Harshul1484/full_panel_cleaner_Robot/gholab4.JPG

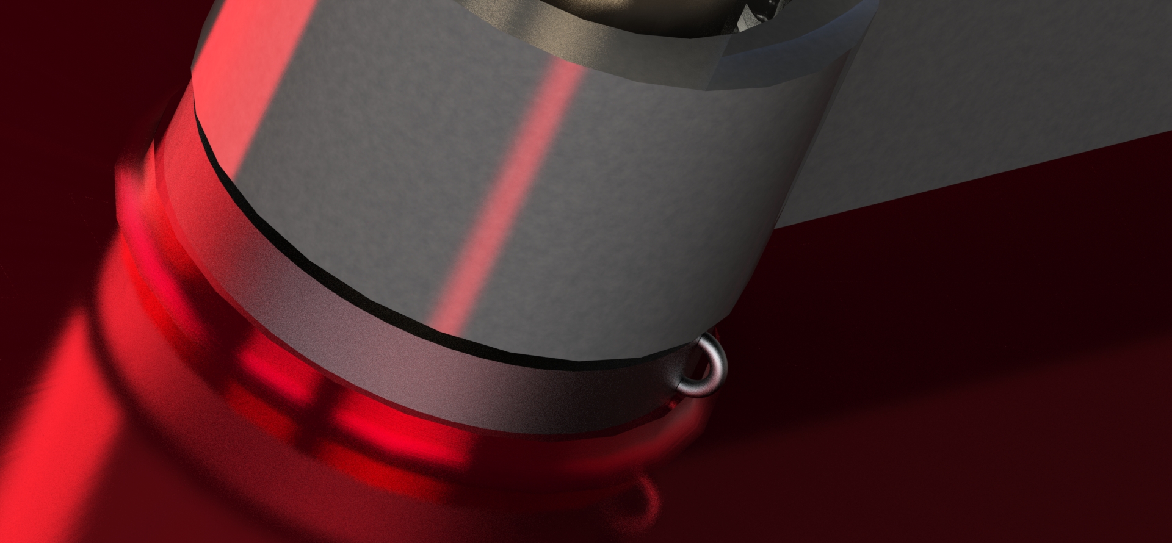
gholab4.JPG
