Harshul1484/full_panel_cleaner_Robot/render2.JPG

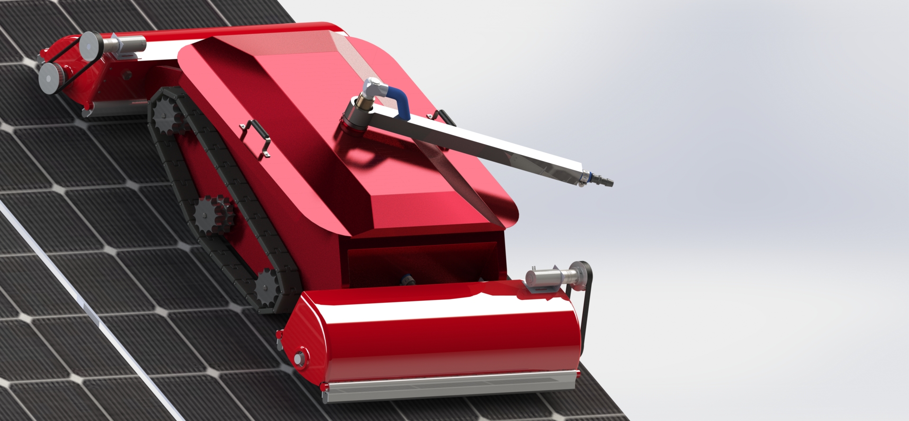
render2.JPG
