Harshul1484/full_panel_cleaner_Robot/render1.JPG

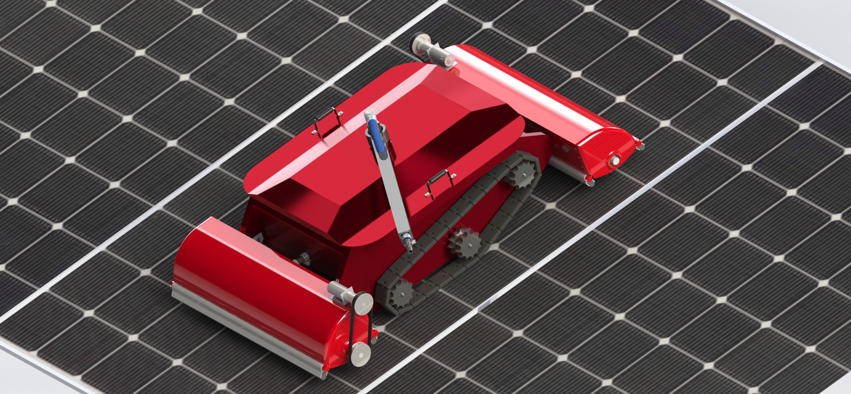
render1.JPG
