Harshul1484/full_panel_cleaner_Robot/robot1.JPG

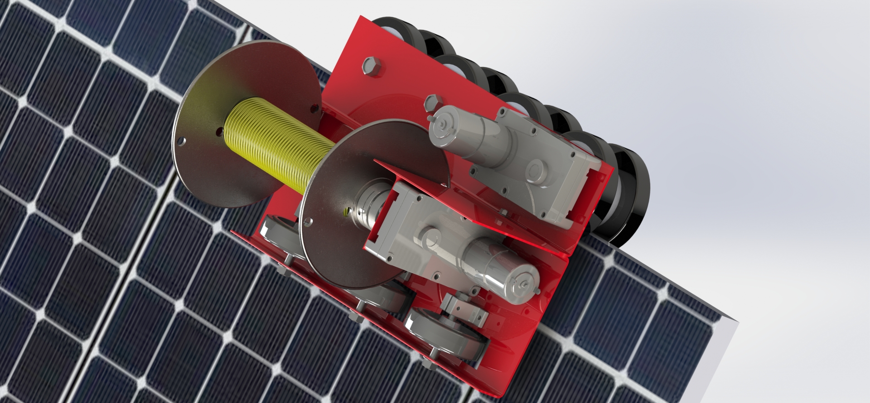
robot1.JPG
