Harshul1484/full_panel_cleaner_Robot/components/3d-print/main_body_part2.stl

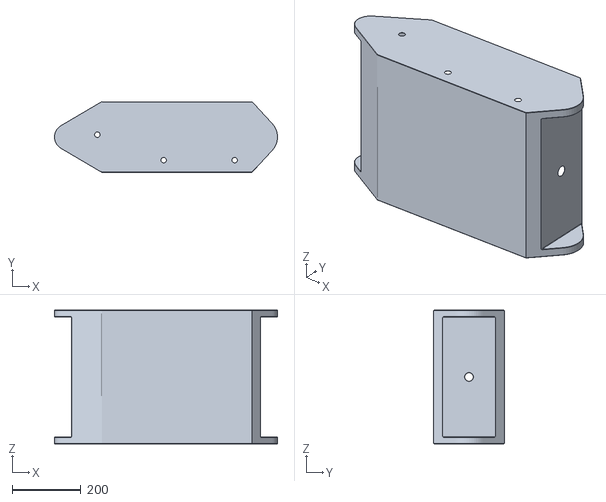
[picture p5: CAD file, 2026-05-20]
components/3d-print/main_body_part2.stl
650.0 x 205.9 x 390.0
