Harshul1484/full_panel_cleaner_Robot/components/assemblies/T-part-assemble.step

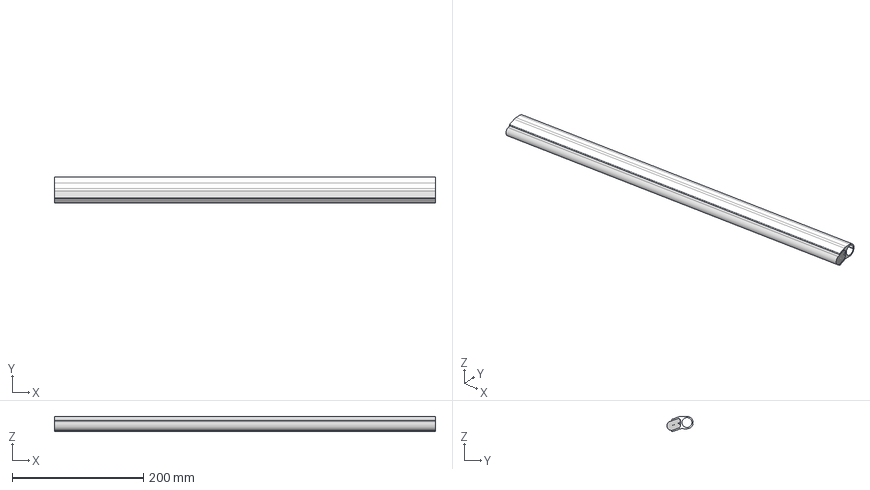
[picture p6: CAD file, 2026-05-20]
components/assemblies/T-part-assemble.step
580.0 x 40.1 x 23.4 mm
