Harshul1484/full_panel_cleaner_Robot/components/3d-print/main_body_part1.stl

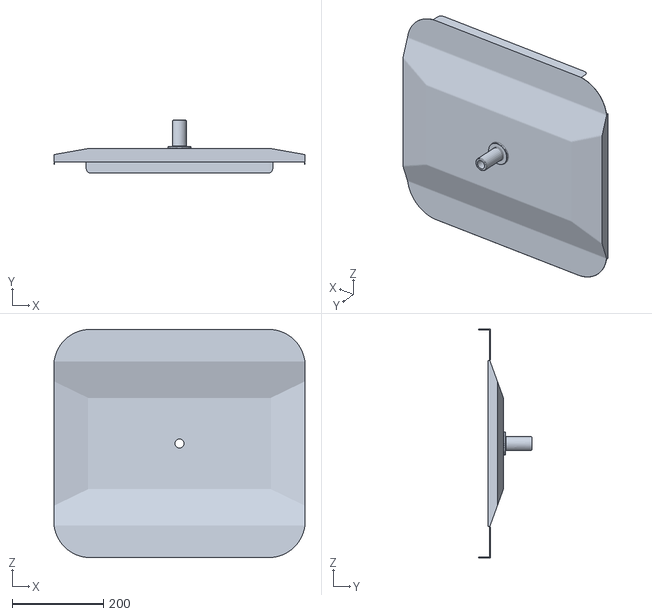
[picture p7: CAD file, 2026-05-20]
components/3d-print/main_body_part1.stl
550.0 x 117.1 x 500.0
