Harshul1484/full_panel_cleaner_Robot/main_body.SLDPRT

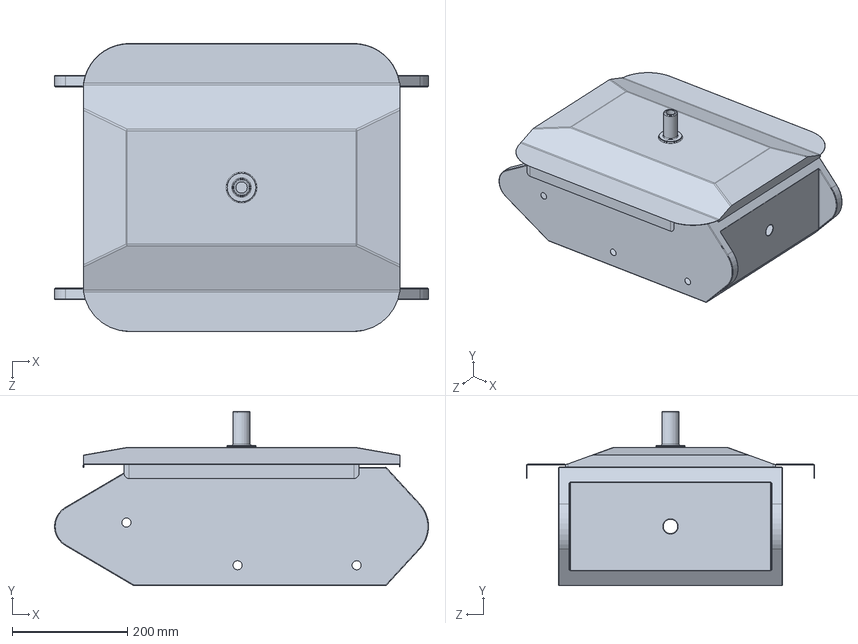
[picture p8: CAD file, 2026-05-20]
main_body.SLDPRT
649.8 x 303.0 x 500.0 mm
