Harshul1484/full_panel_cleaner_Robot/1ofsheni.SLDASM

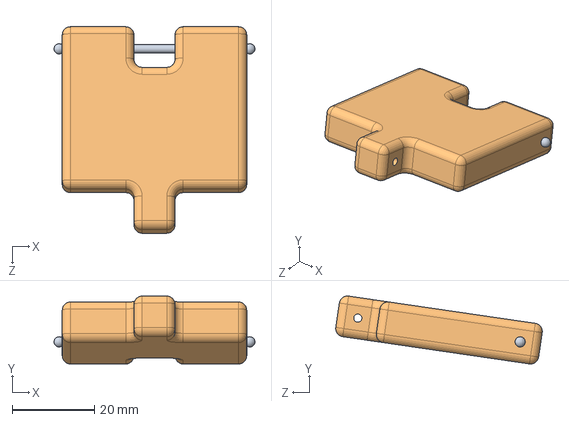
[picture p9: CAD file, 2026-05-20]
1ofsheni.SLDASM
49.0 x 16.6 x 50.4 mm
shaft_sheni
sheni
