Harshul1484/full_panel_cleaner_Robot/components/assemblies/ST-320.step

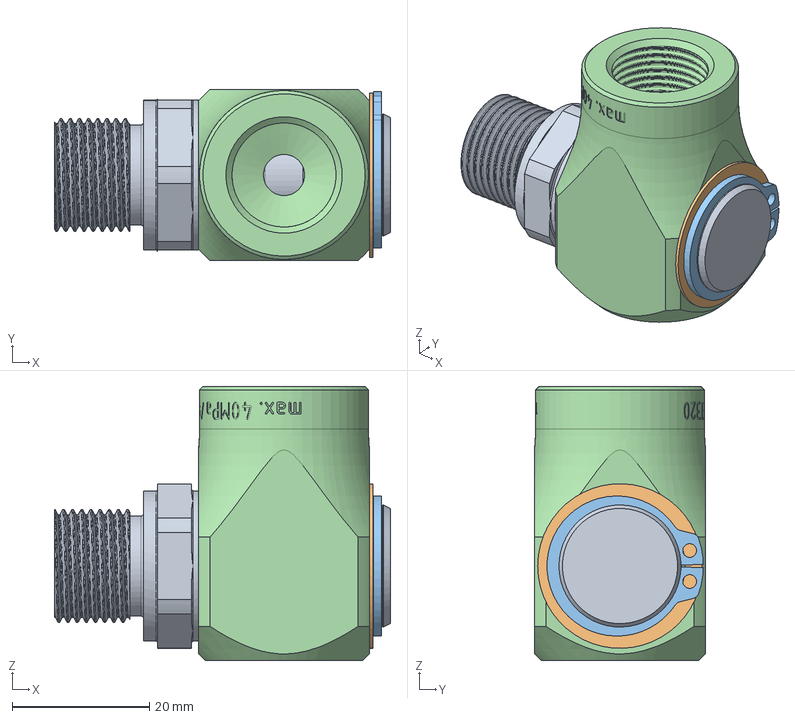
[picture p10: CAD file, 2026-05-20]
components/assemblies/ST-320.step
49.0 x 25.0 x 40.0 mm
