Harshul1484/full_panel_cleaner_Robot/components/cut-mild-steel/structure_body2_40x1000x20mm.stl

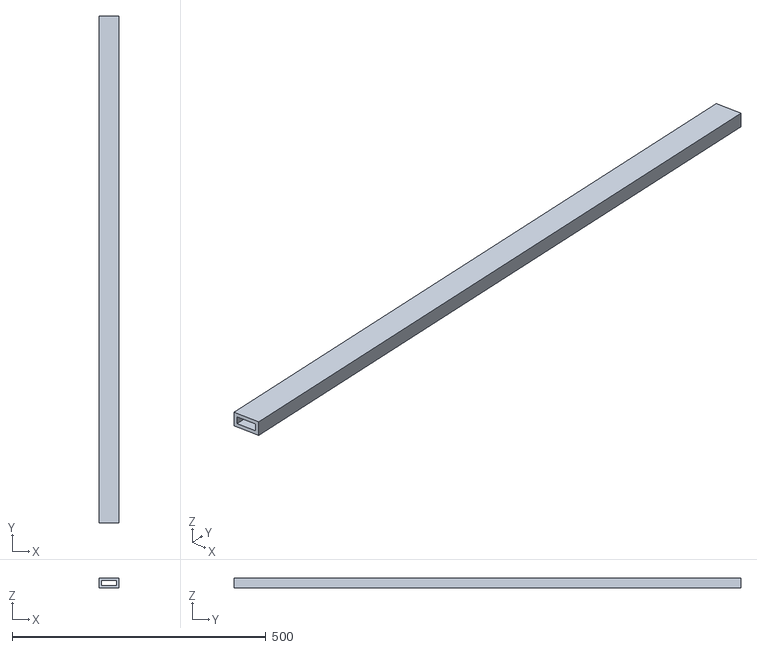
[picture p12: CAD file, 2026-05-20]
components/cut-mild-steel/structure_body2_40x1000x20mm.stl
40.0 x 1000.0 x 20.0
