Harshul1484/full_panel_cleaner_Robot/components/3d-print/T-cleaner-body.step

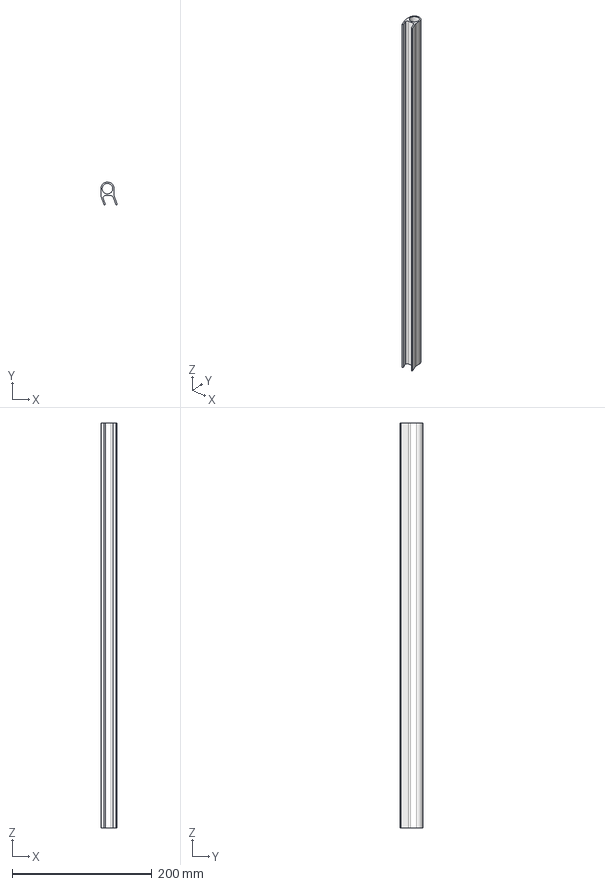
[picture p13: CAD file, 2026-05-20]
components/3d-print/T-cleaner-body.step
23.4 x 32.8 x 580.0 mm
