Harshul1484/full_panel_cleaner_Robot/shaft_sheni.SLDPRT

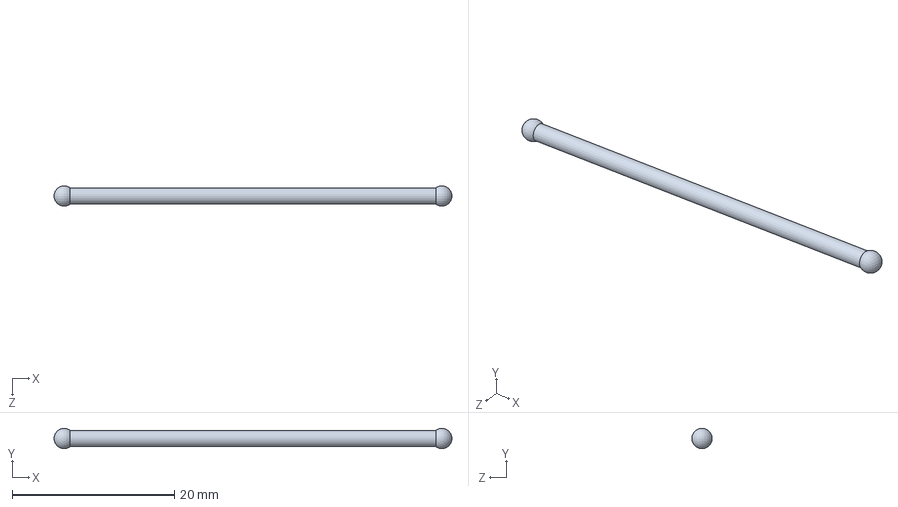
[picture p14: CAD file, 2026-05-20]
shaft_sheni.SLDPRT
49.0 x 2.50 x 2.50 mm
