Harshul1484/full_panel_cleaner_Robot/components/3d-print/motor-DC-shaft.step

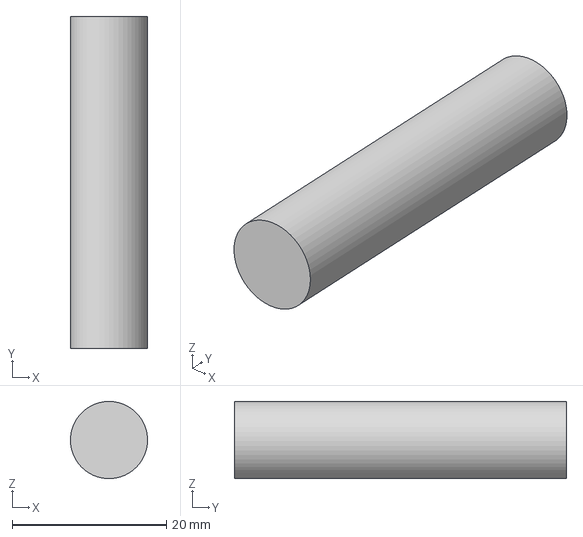
[picture p15: CAD file, 2026-05-20]
components/3d-print/motor-DC-shaft.step
10.00 x 43.0 x 9.99 mm
