Harshul1484/full_panel_cleaner_Robot/components/bought-parts/Composant2.step.step

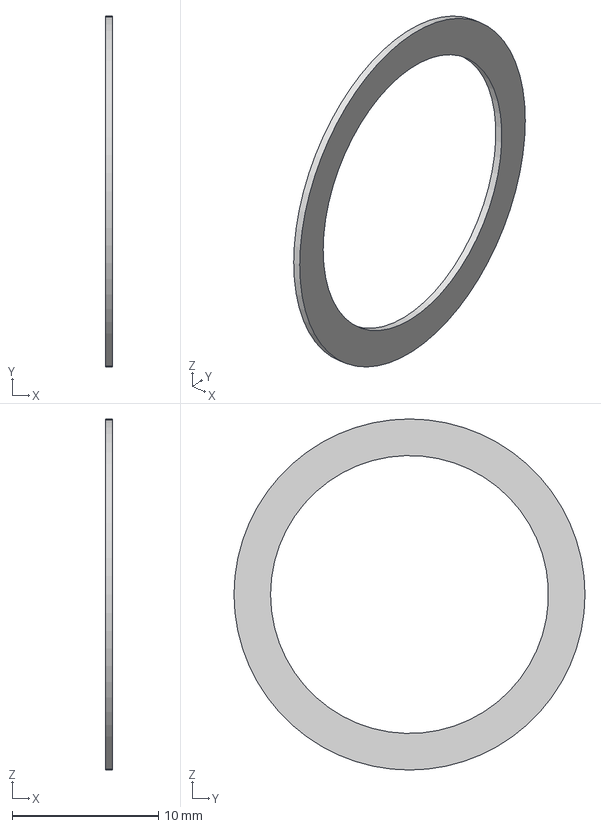
[picture p16: CAD file, 2026-05-20]
components/bought-parts/Composant2.step.step
0.5 x 24.0 x 24.0 mm
