Harshul1484/full_panel_cleaner_Robot/components/cut-mild-steel/structure_body8_40x1866x20mm.stl

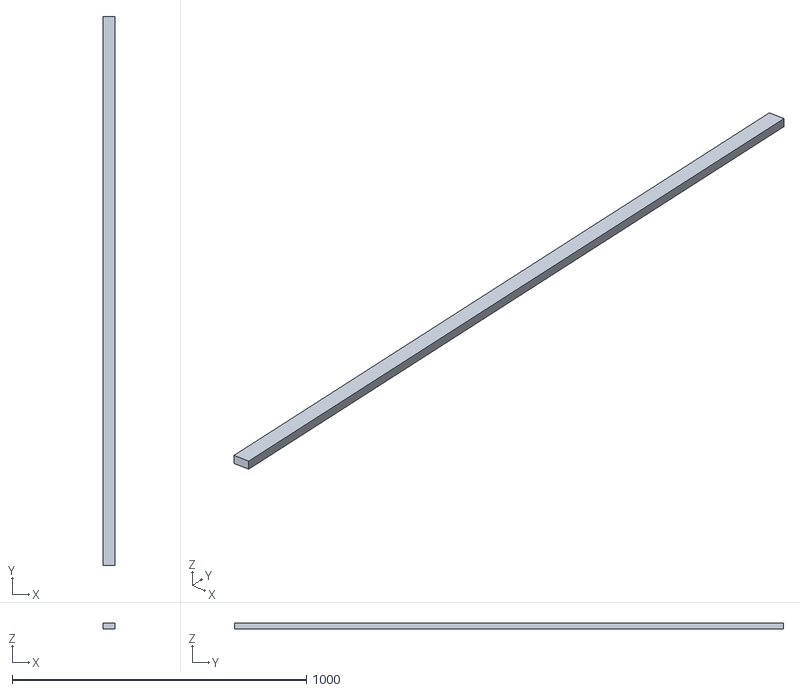
[picture p17: CAD file, 2026-05-20]
components/cut-mild-steel/structure_body8_40x1866x20mm.stl
40.0 x 1866.0 x 20.0
