Harshul1484/full_panel_cleaner_Robot/connector.SLDPRT

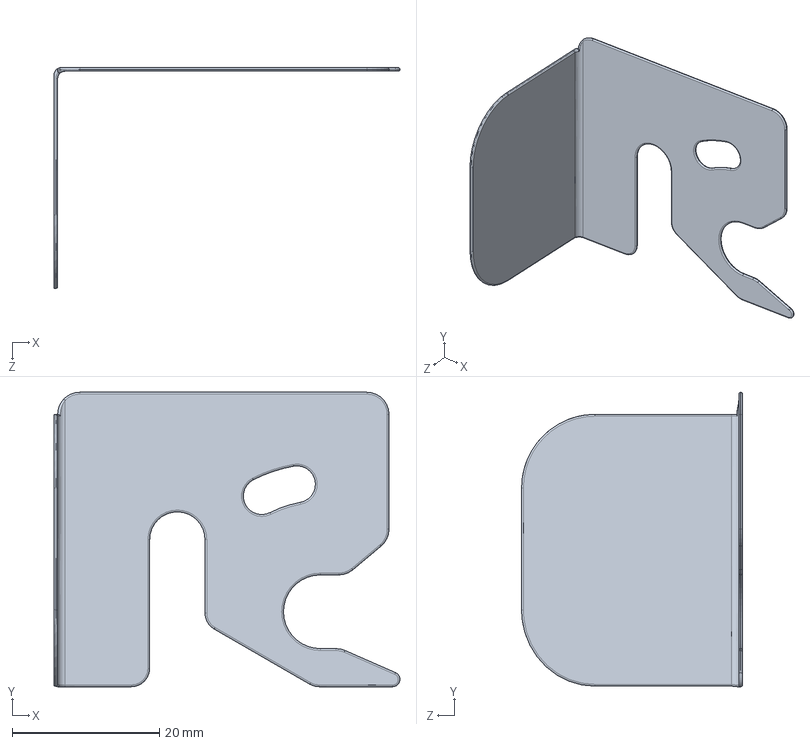
[picture p18: CAD file, 2026-05-20]
connector.SLDPRT
47.0 x 40.0 x 30.0 mm
