Harshul1484/full_panel_cleaner_Robot/components/bought-parts/ST-320.step.step

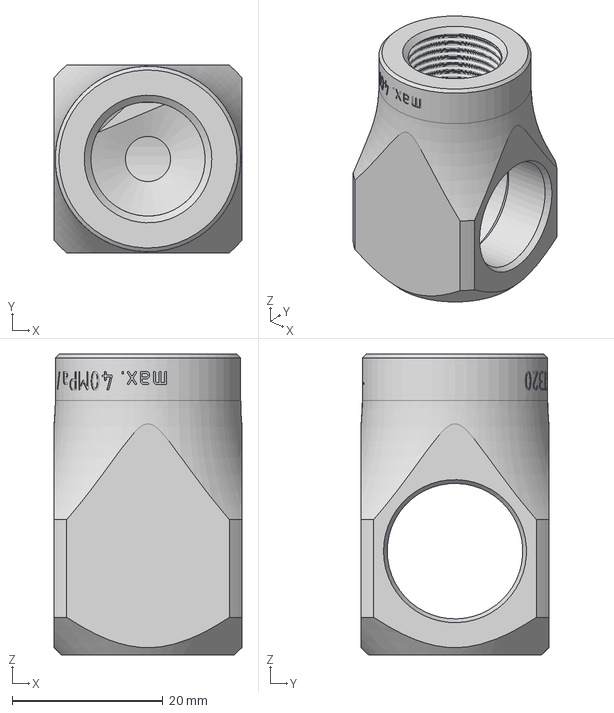
[picture p19: CAD file, 2026-05-20]
components/bought-parts/ST-320.step.step
25.0 x 25.0 x 40.0 mm
