Harshul1484/full_panel_cleaner_Robot/motor-DC-shaft.SLDPRT

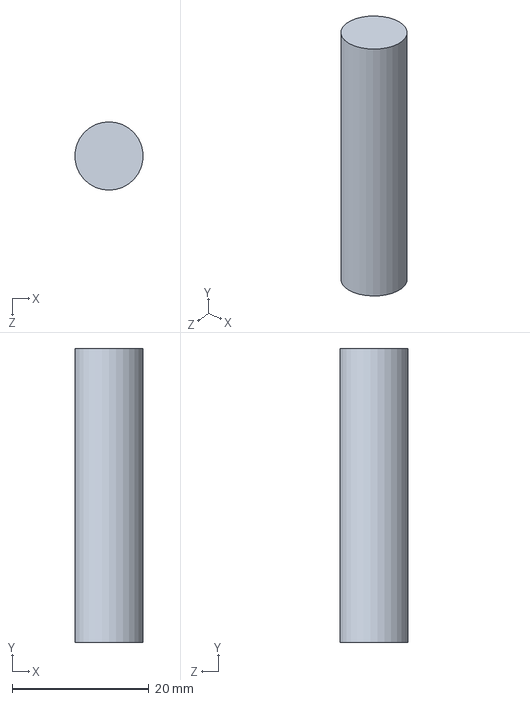
[picture p20: CAD file, 2026-05-20]
motor-DC-shaft.SLDPRT
9.95 x 43.0 x 10.0 mm
