Harshul1484/full_panel_cleaner_Robot/components/3d-print/pin.step

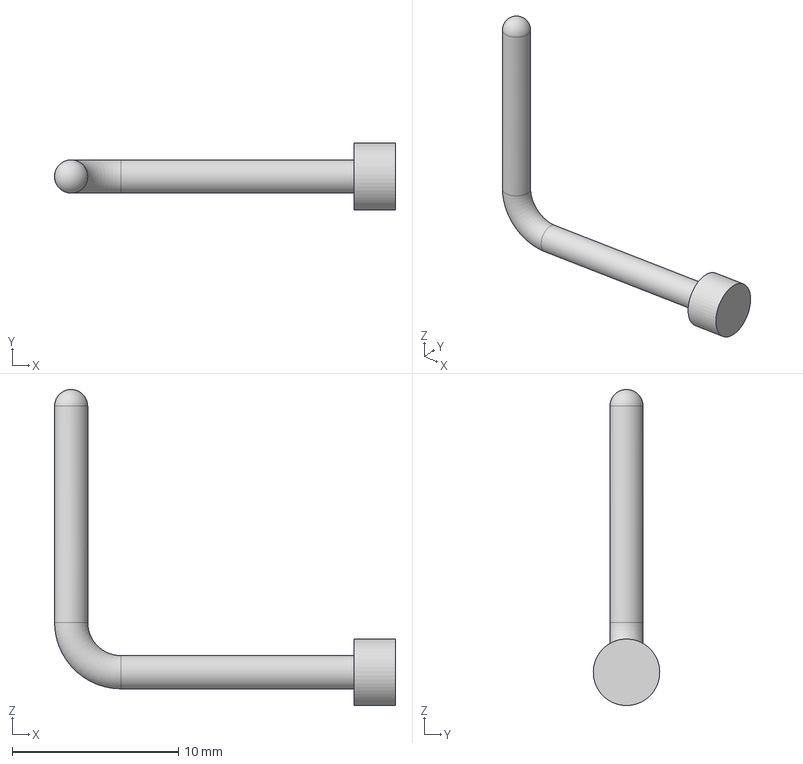
[picture p21: CAD file, 2026-05-20]
components/3d-print/pin.step
20.5 x 4.00 x 19.0 mm
