Harshul1484/full_panel_cleaner_Robot/components/3d-print/dasteh.step

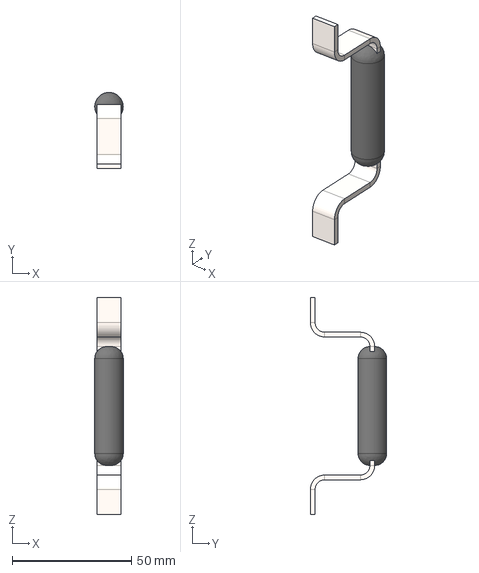
[picture p22: CAD file, 2026-05-20]
components/3d-print/dasteh.step
12.0 x 32.0 x 91.2 mm
