Harshul1484/full_panel_cleaner_Robot/radial ball bearing_68_am.sldprt

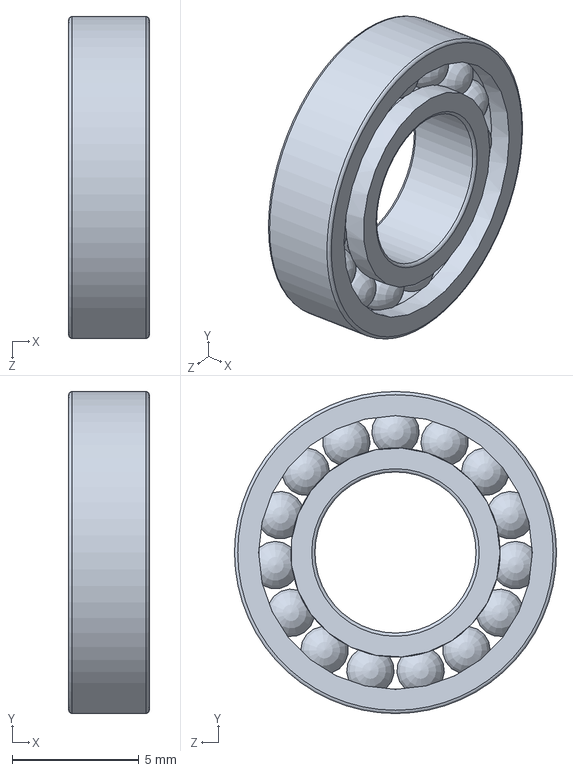
[picture p23: CAD file, 2026-05-20]
radial ball bearing_68_am.sldprt
3.17 x 12.7 x 12.7 mm
