Harshul1484/full_panel_cleaner_Robot/components/3d-print/DC-motor-bracket.step

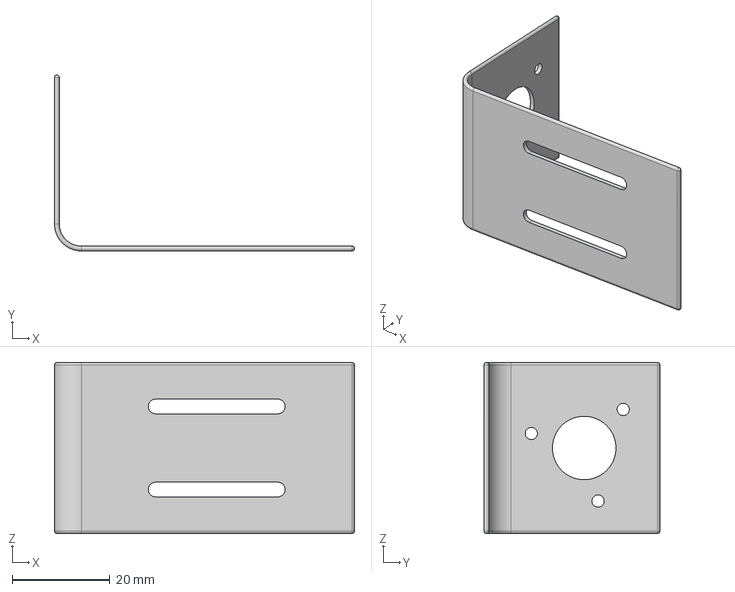
[picture p24: CAD file, 2026-05-20]
components/3d-print/DC-motor-bracket.step
61.4 x 36.0 x 35.0 mm
