Harshul1484/full_panel_cleaner_Robot/components/bought-parts/Axe.step.step

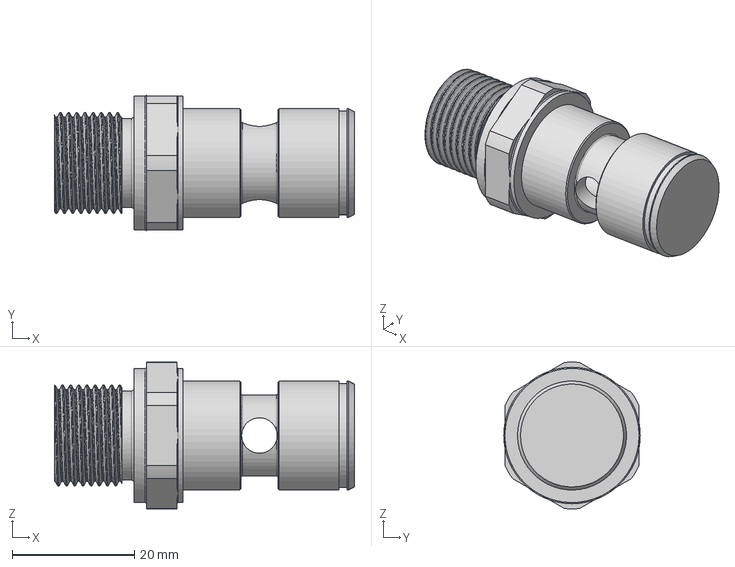
[picture p25: CAD file, 2026-05-20]
components/bought-parts/Axe.step.step
49.0 x 22.3 x 24.0 mm
