Harshul1484/full_panel_cleaner_Robot/components/3d-print/shaft_harzgard.step

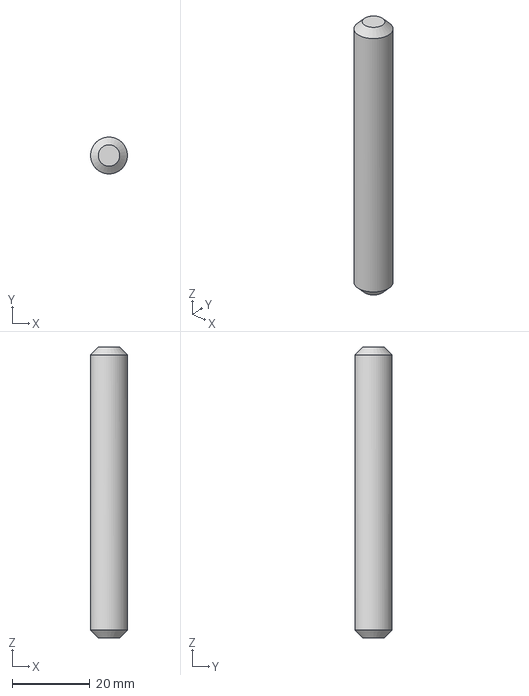
[picture p26: CAD file, 2026-05-20]
components/3d-print/shaft_harzgard.step
9.50 x 9.50 x 75.0 mm
