Harshul1484/full_panel_cleaner_Robot/components/bought-parts/instrument_ball_bearing_ai.step

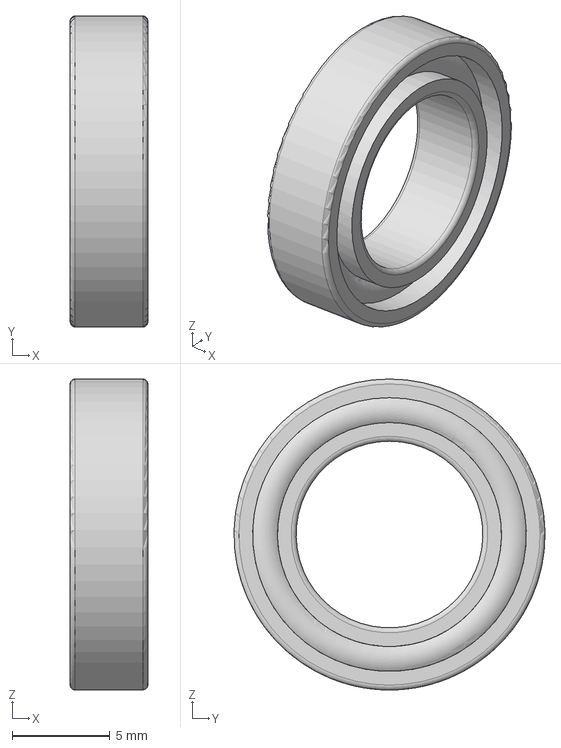
[picture p27: CAD file, 2026-05-20]
components/bought-parts/instrument_ball_bearing_ai.step
3.97 x 15.9 x 15.9 mm
