Harshul1484/full_panel_cleaner_Robot/structure.SLDPRT

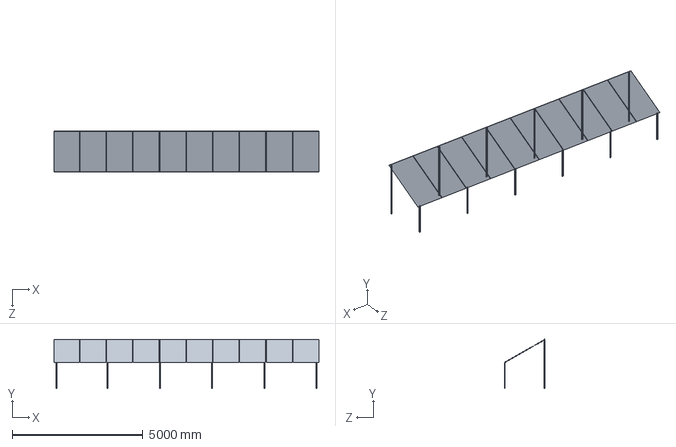
[picture p28: CAD file, 2026-05-20]
structure.SLDPRT
10151.0 x 1892.6 x 1559.9 mm
