Harshul1484/full_panel_cleaner_Robot/instrument ball bearing_ai.sldprt

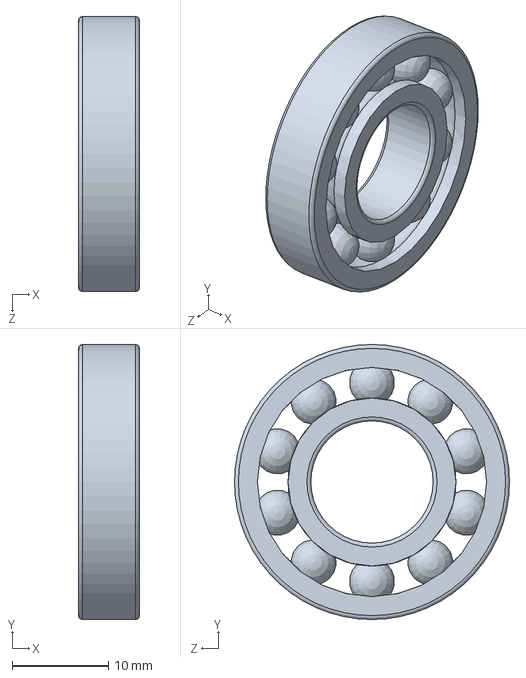
[picture p29: CAD file, 2026-05-20]
instrument ball bearing_ai.sldprt
6.35 x 28.6 x 28.6 mm
