Harshul1484/full_panel_cleaner_Robot/components/3d-print/head-of-T-cleaner.step

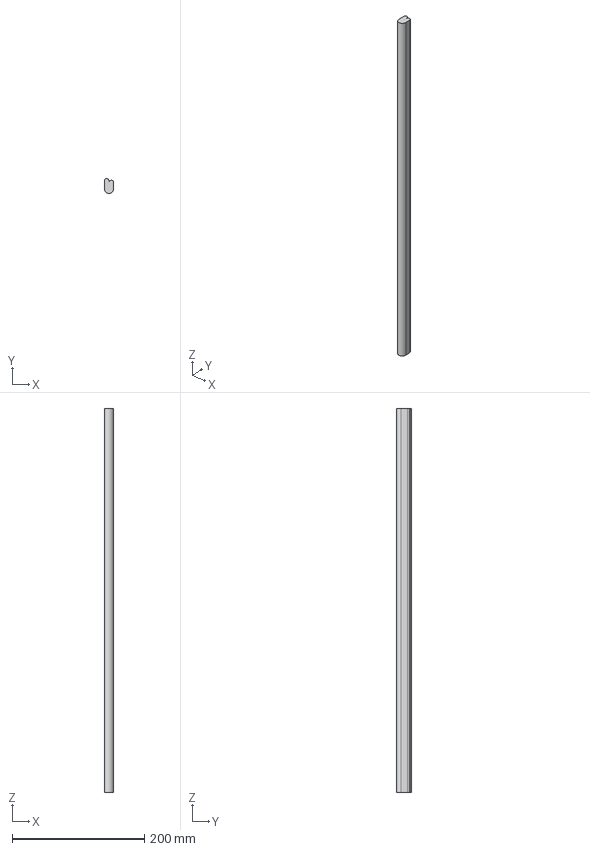
[picture p30: CAD file, 2026-05-20]
components/3d-print/head-of-T-cleaner.step
14.0 x 22.5 x 580.0 mm
