Harshul1484/full_panel_cleaner_Robot/components/3d-print/copling.step

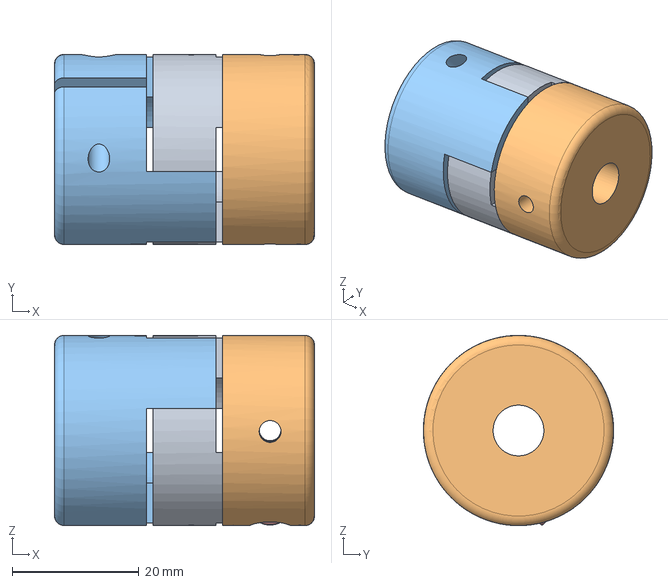
[picture p31: CAD file, 2026-05-20]
components/3d-print/copling.step
41.0 x 30.0 x 30.0 mm
