Harshul1484/full_panel_cleaner_Robot/components/bought-parts/GF555.STEP.step

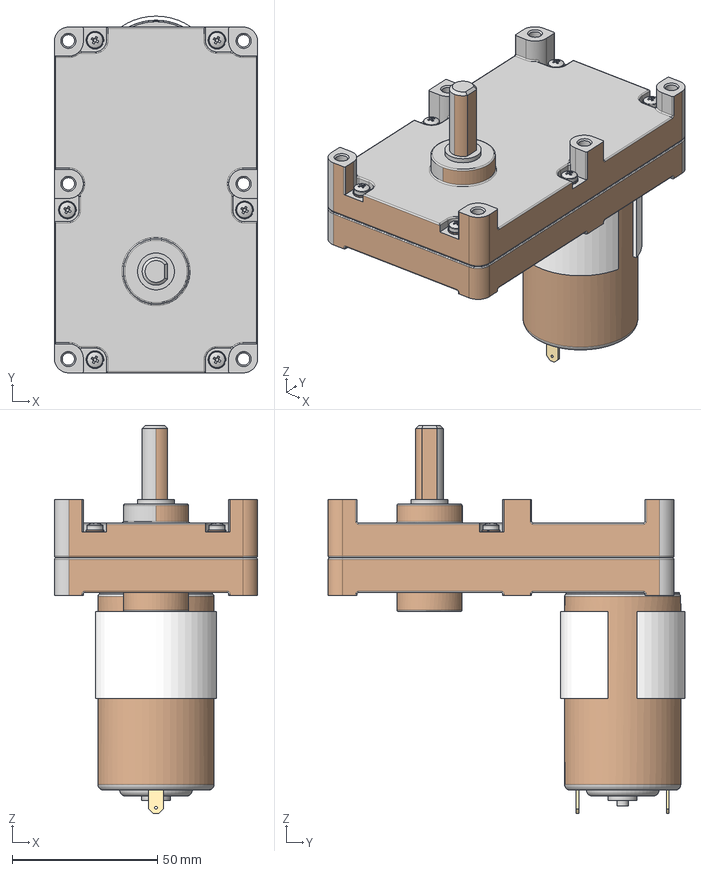
[picture p32: CAD file, 2026-05-20]
components/bought-parts/GF555.STEP.step
70.0 x 122.8 x 133.5 mm
