Harshul1484/full_panel_cleaner_Robot/components/3d-print/loleh_dakheli.step

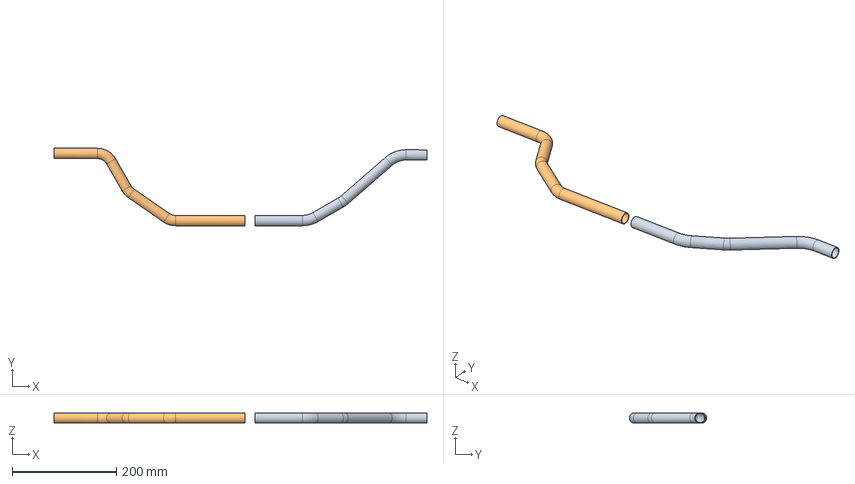
[picture p33: CAD file, 2026-05-20]
components/3d-print/loleh_dakheli.step
715.2 x 148.6 x 20.0 mm
