Harshul1484/full_panel_cleaner_Robot/components/3d-print/3rahi.step

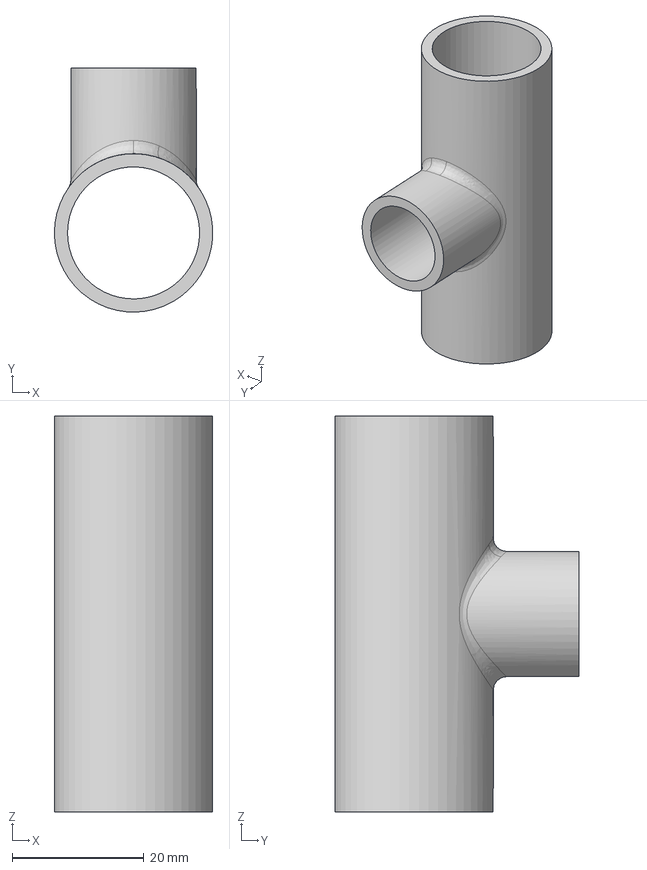
[picture p34: CAD file, 2026-05-20]
components/3d-print/3rahi.step
24.0 x 37.0 x 60.0 mm
