Harshul1484/full_panel_cleaner_Robot/components/bought-parts/6260K9_Double-Strand_Roller_Chain_Idler_Sprocket.step

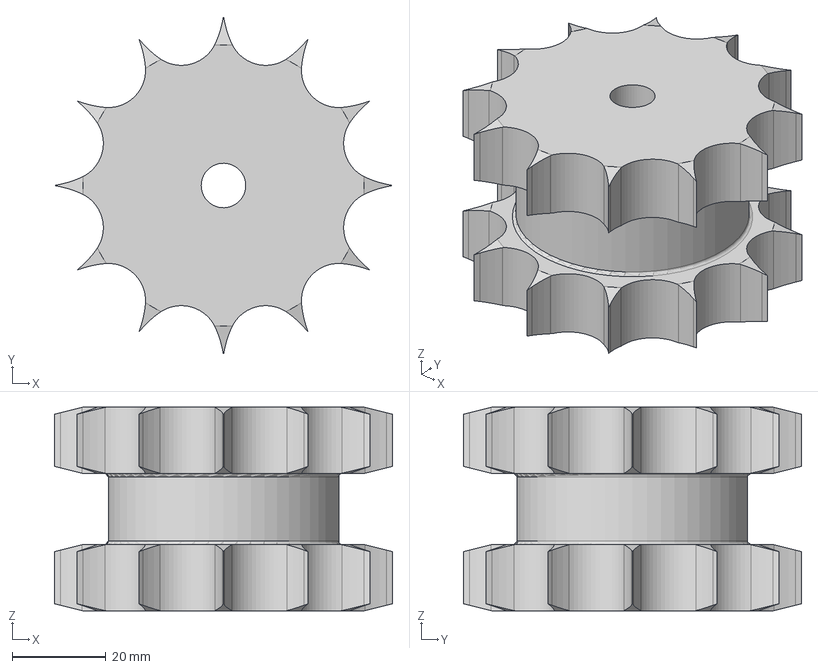
[picture p35: CAD file, 2026-05-20]
components/bought-parts/6260K9_Double-Strand_Roller_Chain_Idler_Sprocket.step
72.1 x 72.1 x 43.4 mm
