Harshul1484/full_panel_cleaner_Robot/components/3d-print/water-jet.step

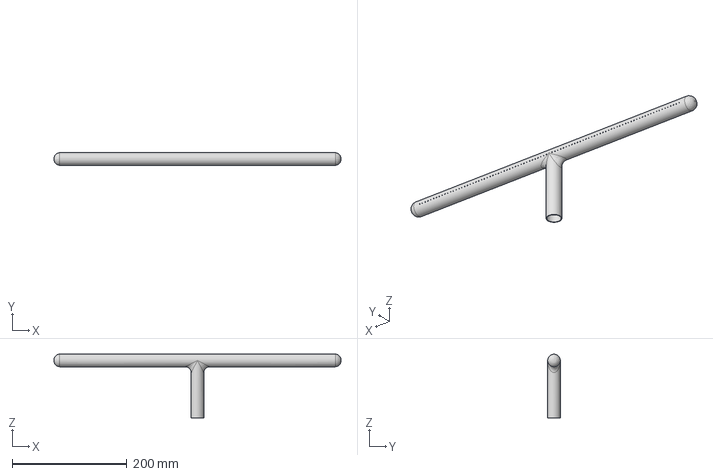
[picture p36: CAD file, 2026-05-20]
components/3d-print/water-jet.step
500.0 x 22.0 x 111.0 mm
