Harshul1484/full_panel_cleaner_Robot/gard.SLDPRT

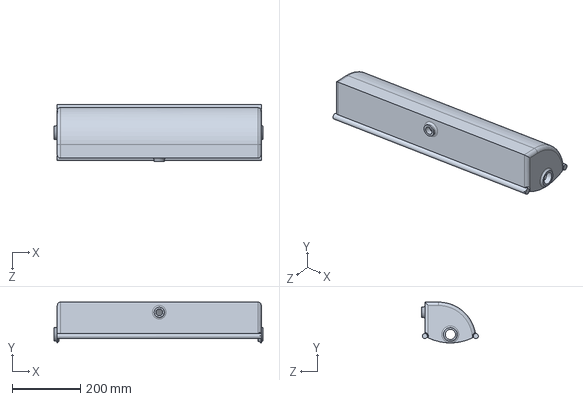
[picture p37: CAD file, 2026-05-20]
gard.SLDPRT
614.5 x 120.1 x 167.0 mm
