Harshul1484/full_panel_cleaner_Robot/3rahi.SLDPRT

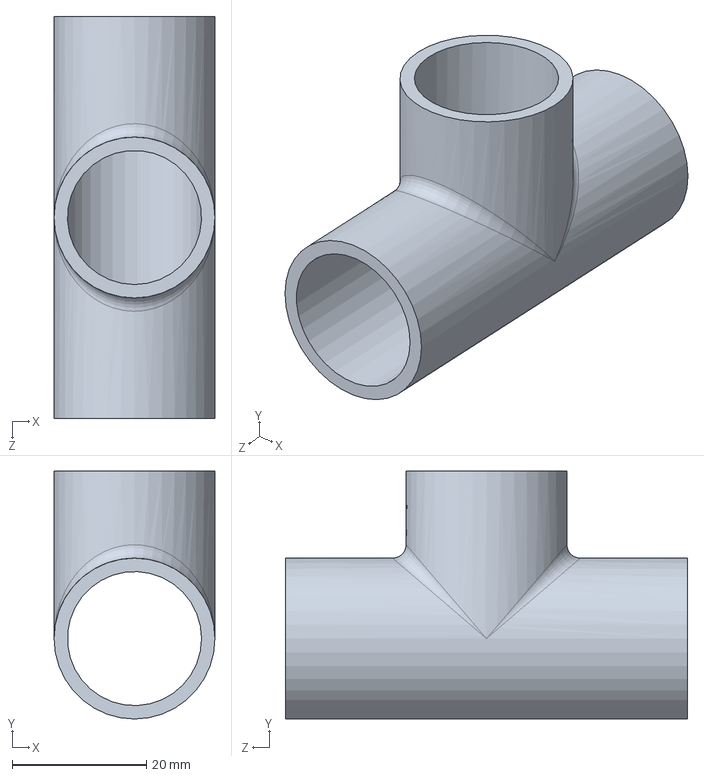
[picture p38: CAD file, 2026-05-20]
3rahi.SLDPRT
24.0 x 37.0 x 60.0 mm
