Harshul1484/full_panel_cleaner_Robot/components/3d-print/sheni.step

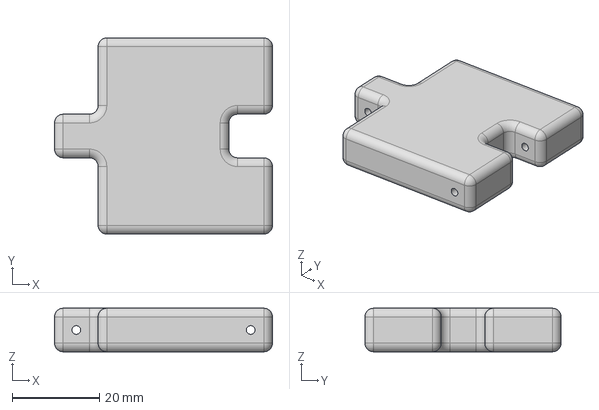
[picture p39: CAD file, 2026-05-20]
components/3d-print/sheni.step
50.0 x 45.0 x 10.0 mm
