Harshul1484/full_panel_cleaner_Robot/components/bought-parts/Variklio_korpusas.STEP.step

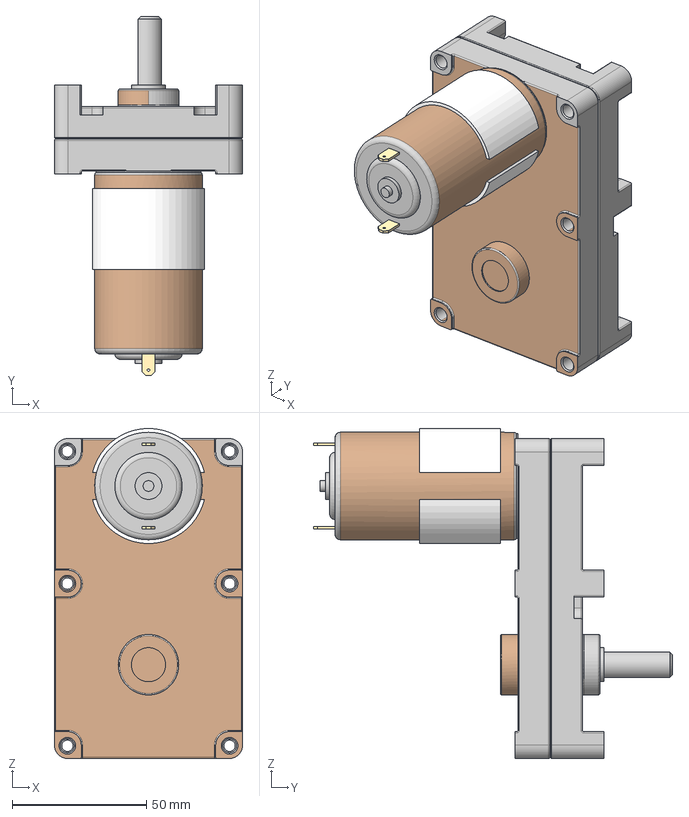
[picture p40: CAD file, 2026-05-20]
components/bought-parts/Variklio_korpusas.STEP.step
70.0 x 133.5 x 122.8 mm
