Harshul1484/full_panel_cleaner_Robot/loleh_dakheli.SLDPRT

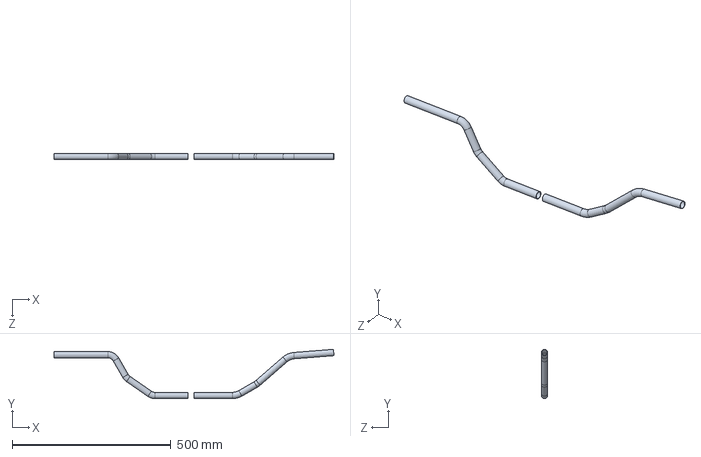
[picture p41: CAD file, 2026-05-20]
loleh_dakheli.SLDPRT
882.8 x 155.5 x 20.0 mm
