Harshul1484/full_panel_cleaner_Robot/(list of files, cad)

Other CAD files:
components/3d-print/main_body.step
T-part-assemble.SLDASM
components/assemblies/1ofsheni.step
components/cut-mild-steel/structure_body6_40x1866x20mm.stl
components/cut-mild-steel/structure_body3_40x1000x20mm.stl
components/3d-print/shaft_sheni.step
components/cut-mild-steel/structure_body9_40x1000x20mm.stl
components/cut-mild-steel/structure_body10_40x1000x20mm.stl
components/cut-mild-steel/structure_body5_40x1866x20mm.stl
components/cut-mild-steel/structure_body4_40x1000x20mm.stl
components/cut-mild-steel/structure_body1_40x1000x20mm.stl
components/cut-mild-steel/structure_body12_40x1866x20mm.stl
dasteh.SLDPRT
components/cut-mild-steel/structure_body7_40x1866x20mm.stl
connector2.SLDPRT
components/3d-print/connector2.step
components/3d-print/connector.step
components/3d-print/gard.step
pin.SLDPRT
T-cleaner-body.SLDPRT
head-of-T-cleaner.SLDPRT
shaft_harzgard.SLDPRT
DC-motor-bracket.SLDPRT
GF555.STEP
sheni.SLDPRT
ST-320.step
6260K9_Double-Strand Roller Chain Idler Sprocket.SLDPRT
water-jet.SLDPRT
copling.SLDPRT
1277N723_Corrosion-Resistant Timing Belt Pulley.SLDPRT
1277N725_Corrosion-Resistant Timing Belt Pulley.SLDPRT
3273T51_304 Stainless Steel Threaded-Rod-Mount Loop Hanger.SLDPRT
4147N173_Set Screw Precision Flexible Shaft Couplings.SLDPRT
5011T11_Worm-Drive Clamp for Firm Hose and Tube.SLDPRT
5972K244_Ball Bearing-brash-gard.SLDPRT
6331K61_Compact Round-Face DC Motor.SLDPRT
9675T18_Odor-Resistant Plastic Barbed Tube Fitting.SLDPRT
ST-320.SLDASM
components/3d-print/3rahi.stl
components/3d-print/Belt1-3.stl
components/3d-print/DC-motor-bracket.stl
components/3d-print/T-cleaner-body.stl
components/3d-print/connector.stl
components/3d-print/connector2.stl
components/3d-print/copling.stl
components/3d-print/dasteh.stl
components/3d-print/gard.stl
components/3d-print/gholab.stl
components/3d-print/head-of-T-cleaner.stl
components/3d-print/loleh.stl
components/3d-print/loleh_dakheli.stl
components/3d-print/motor-DC-shaft.stl
components/3d-print/pin.stl
components/3d-print/rabet.stl
components/3d-print/shaft_harzgard.stl
components/3d-print/shaft_sheni.stl
components/3d-print/sheni.stl
components/3d-print/water-jet.stl
components/bought-parts/1277N723_Corrosion-Resistant_Timing_Belt_Pulley.step
components/bought-parts/1277N725_Corrosion-Resistant_Timing_Belt_Pulley.step
components/bought-parts/3273T51_304_Stainless_Steel_Threaded-Rod-Mount_Loop_Hanger.step
components/bought-parts/4147N173_Set_Screw_Precision_Flexible_Shaft_Couplings.step
components/bought-parts/5011T11_Worm-Drive_Clamp_for_Firm_Hose_and_Tube.step
components/bought-parts/5972K244_Ball_Bearing-brash-gard.step
components/bought-parts/6331K61_Compact_Round-Face_DC_Motor.step
components/bought-parts/90967A220_External_Retaining_Ring.step.step
components/bought-parts/9675T18_Odor-Resistant_Plastic_Barbed_Tube_Fitting.step
components/bought-parts/hex_head_tapping_screw_am.step
components/bought-parts/pan_head_cross_recess_screw_din_ISO_7045_-_M3_x_10_-_Z_---_10N.STEP.step
components/bought-parts/prevailing_torque_hex_flange_nut_am.step
components/bought-parts/socket_countersunk_head_screw_am.step
components/bought-parts/socket_head_cap_screw_ai.step
components/bought-parts/socket_head_cap_screw_am.step
components/bought-parts/socket_set_screw_cup_point_am.step
components/bought-parts/spring_lock_washer_2_din_DIN_6905-3.2-FSt.STEP.step
hex head tapping screw_am.sldprt
prevailing torque hex flange nut_am.sldprt
socket countersunk head screw_am.sldprt
socket head cap screw_ai.sldprt
socket head cap screw_am.sldprt
socket set screw cup point_am.sldprt
