Harshul1484/full_panel_cleaner_Robot/MechanicalBuildGuide.html

# SOLARCLEANERBOT — MECHANICAL BUILD GUIDE

Panel: 2000 × 1000 mm · 2× GF555 Differential Drive · Material: Mild Steel + 3D Print (NO aluminium) · Tools: Laser/Hacksaw, 3D Printer, Drill, Grinder

LASER CUT Flat sheet parts cut by laser 3D PRINT Print on FDM printer CUT/GRIND Hacksaw or angle grinder DRILL Drill press or hand drill BUY Purchase ready-made MACHINE Lathe / milling needed

TABLE OF CONTENTS

Understanding the robot

How the robot works mechanically

Phase 1 — Materials & Shopping

Complete laser cut parts list Mild steel stock to buy and cut to size (no aluminium) 3D printed parts list Bolts, nuts, bearings — full hardware list with sizes Ready-made bought parts

Phase 2 — Chassis Frame

Building the main frame step by step

Phase 3 — Drive System

Track drive: 2× GF555 motors (differential) + sprockets + ST-320 chain

Phase 4 — Brush Wash Assembly

Brush rollers + motor + belt drive + water jet

Phase 5 — Sensor Mounting

All sensors — exact positions and how to mount them

Phase 6 — Final Assembly

Putting it all together in order

Phase 7 — Checks Before First Run

Mechanical checklist before powering on

0

HOW THE ROBOT WORKS — READ THIS FIRST

Simple explanation of every mechanical part before you build anything

🚗 How it moves

Two GF555 motors — one per side. Left motor drives the left track, right motor drives the right track independently. By running them at different speeds or opposite directions the robot steers and spins in place — called differential drive, exactly like a tank.

🧹 How it cleans

Two brush rollers (front and rear, each 650mm wide) spin and scrub the panel. A water jet pipe sprays water ahead of the front brush. Together they wet-scrub the whole panel surface.

🔄 How it knows where it is

IR sensors at each corner look down. When a sensor sees no surface (panel edge), the robot knows to turn. It sweeps in an S-pattern row by row until the full panel is clean.

1A

LASER CUT PARTS LIST LASER CUT

Send these files to a laser cutting service or cut yourself — all flat sheet parts

ℹ If you don't have a laser cutter, services like SendCutSend, Xometry, or local fab labs will cut these from a DXF file. Get the DXF from your SolidWorks model for each part below. All structural parts are mild steel — cheaper, stronger, easier to weld, widely available.

⚠ Rust protection is mandatory. Mild steel corrodes outdoors on a solar panel. After cutting and drilling ALL steel parts: sand edges smooth → apply zinc primer spray → top-coat with outdoor enamel paint. Do this before assembly. Alternatively, buy galvanised (zinc-coated) mild steel sheet — same price, pre-protected.

Side Plates, End Plates & Frame — 3mm Mild Steel Sheet

Part Name | Size (mm) | Qty | Material | Notes
Left Side Plate | 820 × 150 × 3mm | 1 | Mild steel 3mm sheet | Main left wall of chassis. Has holes for bearing mounts and motor shaft. Use galvanised sheet or paint after cutting.
Right Side Plate | 820 × 150 × 3mm | 1 | Mild steel 3mm sheet | Mirror image of left plate. Same hole pattern. Can weld cross braces directly to steel — stronger than bolted connections.
Front End Plate | 650 × 150 × 3mm | 1 | Mild steel 3mm sheet | Closes the front of chassis. Has 2 holes for ultrasonic sensors. Weld or bolt to side plates.
Rear End Plate | 650 × 150 × 3mm | 1 | Mild steel 3mm sheet | Closes the rear. Has 1 hole for dock IR sensor.
Cross Brace | 650 × 40 × 3mm | 3 | Mild steel 3mm sheet | Connect left and right side plates for rigidity. Can be welded (strongest) or bolted M4×12mm.
Top Cover Plate | 820 × 650 × 2mm | 1 | Mild steel 2mm sheet | Top lid. Has cutouts for battery access, water tank fill port. Not load-bearing. Paint both sides.
Electronics Tray | 600 × 200 × 2mm | 1 | Mild steel 2mm sheet | Mounts inside chassis on nylon standoffs. Arduino Mega, 2× BTS7960, L298N, buck converters, ESP8266. Paint top surface to prevent short circuits.
Motor Mount Plate | 140 × 140 × 3mm | 2 | Mild steel 3mm sheet | One per GF555 motor (LEFT + RIGHT). Each has 4× M4 holes matching GF555 face bolt pattern. Can weld to side plate for maximum rigidity.
Brush Assembly Side Bracket | 200 × 120 × 3mm | 4 | Mild steel 3mm sheet | 2 per brush assembly (front + rear). Hold the brush roller shaft bearings. Paint before assembly.
Splash Guard (gard) | 615 × 120 × 2mm | 2 | Mild steel 2mm sheet | One per brush assembly. Curves over brush roller to contain water. Bend on a sheet metal brake or tap with mallet over a rounded edge. Paint both sides — water contact part.
Battery Tray | 300 × 180 × 2mm | 1 | Mild steel 2mm sheet | Cradle for battery pack inside chassis. Drill drain holes in corners. Paint.
Sensor Corner Bracket | 60 × 60 × 2mm (L-shape) | 4 | Mild steel 2mm sheet | One per corner for IR edge sensors. L-shaped — fold at 90° after laser cutting using a vice and mallet.
Water Tank Bracket | 200 × 40 × 2mm | 2 | Mild steel 2mm sheet | Clamps that hold the 350mL water tank to chassis top. Paint to prevent rust from water contact.

✓ Welding option: If you have access to a MIG or stick welder, weld the side plates, end plates, and cross braces together instead of bolting — this is stronger and removes the need for cross-brace bolt holes. Weld, then grind smooth, then prime and paint the whole chassis as a single unit.

✓ Tip for beginners: When you send DXFs for laser cutting, ask for "deburr and clean edges" — steel edges are razor-sharp after laser cutting. Also request galvanised mild steel if available — same cost, no painting needed for rust protection.

1B

MILD STEEL STOCK — CUT TO SIZE (NO ALUMINIUM) CUT/GRIND DRILL

Buy these as standard stock lengths and cut down with hacksaw or angle grinder — all mild steel, no aluminium

ℹ All bar, rod, tube and flat bar is mild steel. Mild steel is much cheaper than aluminium, available at any hardware or steel supplier, and easy to cut with a hacksaw or angle grinder. Paint all pieces with zinc primer after cutting to prevent rust.

Part / Use | Stock Type | Size to Buy | Cut To | Qty Needed | How to Cut
Main drive shafts (one per motor side) | Mild steel round bar | Ø10mm × 1000mm length | Ø10 × 700mm each | 2 pieces (LEFT + RIGHT) | Angle grinder + cut-off disc. File ends flat after cutting.
Sprocket shafts (shaft_sheni × 27 per side = 54 total) | Mild steel round bar | Ø10mm × 3200mm lengths (buy 2 lengths = 6.4m total) | Ø10 × 49mm each | 54 pieces — model confirms 27 per side × 2 sides = 54 shafts total. Buy 6.5m of 10mm rod. | Mark with marker every 49mm. Cut with hacksaw. File both ends flat — must be flush so E-clips seat properly.
Idler shafts (shaft_harzgard × 6) | Mild steel round bar | Ø10mm × 500mm length | Ø10 × 75mm each | 6 pieces | Hacksaw. File ends flat.
Brush roller shaft (front brush) | Mild steel round bar | Ø20mm × 700mm length | Ø20 × 670mm | 1 piece | Hacksaw or angle grinder. Sand ends smooth with 80-grit paper. Must be straight — roll on flat surface to check. Paint shaft to prevent rust under the brush sleeve.
Brush roller shaft (rear brush) | Mild steel round bar | Ø20mm × 700mm length | Ø20 × 670mm | 1 piece | Same as front brush shaft. Paint before fitting microfiber sleeve.
Water jet pipe (water-jet × 2) | Mild steel round tube (or 304 stainless tube) | Ø22mm OD × 1.5mm wall × 600mm | Ø22 × 500mm each | 2 pieces (1 per brush assembly) | Hacksaw. Drill 1.5mm holes every 50mm along bottom for spray. Paint outside only — inside carries water so leave bare or use food-safe paint. (304 stainless tube is better here if budget allows — no rust inside.)
Handle brackets (dasteh × 2) | Mild steel flat bar | 20 × 5mm × 200mm | 20 × 5 × 91mm | 2 pieces | Hacksaw. Drill 2× M4 holes at each end. Paint.
Loleh tensioner bar | Mild steel flat bar | 20 × 5mm × 500mm | 20 × 5 × 445mm | 1 piece | Hacksaw. Drill slot holes for tension adjustment (drill 2 holes end-to-end, file out the web between them). Paint.
rabet connector bar | Mild steel flat bar | 30 × 5mm × 500mm | 30 × 5 × 450mm | 1 piece | Hacksaw. Drill 4× M4 holes — 2 at each end. Paint.
gholab sub-frame | Mild steel angle bar 25×25×3mm | 200mm length | 51mm pieces | 2 pieces | Hacksaw. File edges flat. Paint.

✓ One purchase: Buy 10mm round bar in a single 3000mm length — this gives you all the sprocket shafts (54 pieces × 49mm + 6 idler shafts × 75mm = 2646mm + 450mm = 3096mm). Buy a 3.2m length to have spare.

⚠ When cutting steel with an angle grinder, always wear: safety glasses, gloves, and do NOT wear loose clothing. Sparks can travel 2–3 meters. Never use an angle grinder without the guard fitted.

✓ Buy 10mm mild steel rod in two 3250mm lengths (6.5m total) — this gives you all 54 sprocket shafts + 6 idler shafts from one purchase.

1C

3D PRINTED PARTS 3D PRINT

Print in PETG or ABS — not PLA (PLA warps in outdoor heat)

ℹ Use PETG filament for all outdoor parts — it handles heat up to 80°C and is UV resistant. PLA will warp/deform in direct sunlight on a solar panel.

Part Name | Model Ref | Qty | Print Settings | Function
Motor Mount Adapter | copling | 2 | 40% infill, 3 walls, PETG | Connects GF555 motor shaft to drive shaft. Size: 41×30×30mm. Has set-screw hole.
3-Way Bracket | 3rahi | 1 | 50% infill, 4 walls, PETG | Junction bracket connecting 3 frame members. Size: 24×37×60mm.
Brush Connector Left | connector | 2 | 40% infill, 3 walls, PETG | Locks the brush assembly to the chassis. Size: 47×40×30mm.
Brush Connector Right | connector2 | 2 | 40% infill, 3 walls, PETG | Mirror of connector. Size: 47×40×30mm.
Hinge Pin Housing | pin | 4 | 60% infill, 4 walls, PETG | Holds the hinge pin for brush assembly articulation. Size: 21×4×19mm. Tiny — print 4 at once.
DC Motor Bracket | DC-motor-bracket | 2 | 40% infill, 4 walls, PETG | Holds 6331K61 DC motor on each brush assembly. Size: 61×36×35mm.
IR Sensor Mount | (new, not in model) | 4 | 30% infill, 2 walls, PETG | Small L-bracket to hold TCRT5000 IR sensor pointing down at corner. Design: 40×40×20mm L-shape with 2 M3 holes.
Ultrasonic Sensor Mount | (new, not in model) | 2 | 30% infill, 2 walls, PETG | Holds HC-SR04 on front plate pointing forward. 50×40×20mm with two 16mm circular cutouts for sensor faces.
Water Tank Mount | (new, not in model) | 1 | 40% infill, 3 walls, PETG | Cradle for 350mL water tank on top of chassis. 200×100×40mm box with open top and strap slots.
gholab frame piece | gholab | 2 | 50% infill, 4 walls, PETG | Internal frame connector. Size: 51×7×48mm.
T-part fluid splitter | T-part-assemble | 4 | 60% infill, 4 walls, PETG | 2 per brush assembly × 2 assemblies = 4 total. Each T-part splits water to the left and right halves of the brush roller nozzles. Size: ~580×42×23mm each — print in 3 sections (~193mm each) and join with silicone sealant.
Dock station IR holder | (new) | 1 | 30% infill, 2 walls, PETG | Small box mounted at dock to hold the IR LED that the robot detects.

⚠ The T-part at 580mm is longer than most printer beds (250mm). Split it into 3 pieces and join with M3 bolts + silicone sealant for water tightness.

1D

BOLTS, NUTS, BEARINGS — COMPLETE LIST WITH EXACT SIZES BUY

Every single bolt and bearing you need — buy all before starting assembly

Bearings

Bearing Type | Size (ID × OD × Width) | Qty | Used For | Standard Code
Radial ball bearing (large) | Ø8 × 44 × 5mm (approx) | 2 | Main drive shaft — one on each side plate | Model ref: radial ball bearing_68_am
Radial ball bearing (small) | Ø6 × 37 × 4mm (approx) | 2 | Secondary shaft bearing | Model ref: radial ball bearing_68_am (1)
Instrument ball bearing (idler) | Ø4 × 16 × 4mm (approx) | 6 | Idler shaft_harzgard × 6 — one bearing each | Model ref: instrument ball bearing_ai
Brush assembly bearing | Ø5 × 30 × 7mm (approx) | 4 | Brush roller shaft — 2 per brush assembly × 2 assemblies | Model ref: 5972K244 Ball Bearing

ℹ Take the model dimensions to a bearing supplier (any engineering shop). The exact bearing code (6800, 608, etc.) depends on the bore diameter — measure your shaft and ask the shop to match it.

Bolts — Stainless Steel (won't rust on solar panel)

Bolt Type | Size | Length | Qty | Used For
Socket Head Cap Screw (M3) | M3 | 10mm | 20 | Sensor mounts, small brackets, 3D printed parts
Socket Head Cap Screw (M3) | M3 | 16mm | 20 | Electronics tray, DC motor bracket
Socket Head Cap Screw (M4) | M4 | 12mm | 20 | Side plates to cross braces, motor mount plate
Socket Head Cap Screw (M4) | M4 | 20mm | 20 | GF555 motor to motor mount plate
Socket Head Cap Screw (M4) | M4 | 30mm | 10 | Brush assembly side brackets to chassis
Socket Head Cap Screw (M5) | M5 | 16mm | 10 | Main frame assembly — heavy load joints
Socket Set Screw (M3 grub) | M3 | 6mm | 25 | Lock sprockets and pulleys on shafts — one per sprocket
Tapping Screw (M3 self-tap) | M3 | 12mm | 10 | Into 3D printed plastic parts where threading is hard
Hex Head Tapping Screw | M4 | 20mm | 6 | Model ref: hex head tapping screw_am — brush assembly

Nuts & Washers

Type | Size | Qty | Used For
Hex Nut | M3 | 30 | Matching all M3 bolts
Hex Nut | M4 | 30 | Matching all M4 bolts
Hex Nut | M5 | 10 | Matching M5 bolts
Nyloc Nut (locking) | M4 | 20 | Anywhere that vibrates — track area, motor mount
Prevailing Torque Flange Nut | M4 | 4 | Model ref: prevailing torque hex flange nut_am — brush assembly
Flat Washer (DIN 125) | M3 | 30 | Under bolt heads — spreads load on steel and 3D printed parts
Flat Washer (DIN 125) | M4 | 30 | Under bolt heads on all steel joints
Spring Washer | M4 | 20 | Under nuts on vibrating joints

Shaft Hardware

Item | Size | Qty | Used For
Circlip (E-clip external) | Ø10mm shaft | 20 | Keep bearings and sprockets from sliding off shaft ends
Shaft collar | Ø10mm bore | 6 | Lock idler shafts at correct position in side plates
Woodruff key / flat key | 3×3×10mm | 2 | Lock drive sprocket to main shaft (alternative to set screw only)

✓ Buy 10% extra of all bolts and nuts. You will drop some, strip some, and lose some. It's much better than stopping mid-assembly for a missing M4 nut.

1E

READY-MADE PARTS — JUST BUY THESE BUY

Do not try to make these yourself — buy exact parts

Part | Model Ref | Spec from Model | Qty | Where to Buy
GF555 Geared DC Motor | GF555.STEP | 24V, 70×123×134mm body | 2 (one per track side — LEFT + RIGHT) | AliExpress search: "GF555 DC motor 24V" or "555 geared motor 24V" — buy a matched pair if possible
ST-320 Rubber Track | ST-320.step | Complete track module, 49×25×42mm per link | 1 set | AliExpress search: "ST-320 track" or "rubber track crawler 320"
Double-Strand Roller Chain Idler Sprocket | 6260K9 (McMaster) | 72×72×43mm | 6 (3 per track side — front/center/rear tensioner) | McMaster-Carr #6260K9 or equivalent from AliExpress
Compact Round-Face DC Motor (brush) | 6331K61 (McMaster) | 30×37×83mm, 12V | 2 | McMaster-Carr #6331K61 or similar small DC motor 12V 30mm body
Timing Belt Pulley (large) | 1277N725 | 57×57×23mm | 2 | McMaster-Carr #1277N725 or matching belt pulley from AliExpress
Timing Belt Pulley (small) | 1277N723 | 54×54×23mm | 2 | McMaster-Carr #1277N723 or matching belt pulley from AliExpress
Set Screw Flexible Shaft Coupling | 4147N173 | 25×25×38mm | 2 | McMaster-Carr #4147N173 — connects motor shaft to brush roller shaft
Timing Belt (Belt1-3) | Belt1-3 | 107mm span × 11mm wide | 2 | Match to your pulley pitch (HTD 3M or GT2). Buy 200mm belt and cut.
Barbed Tube Fitting | 9675T18 (McMaster) | 67×17×17mm | 3 | McMaster-Carr #9675T18 — water hose barb connectors
Worm-Drive Hose Clamp | 5011T11 (McMaster) | 28×30×17mm | 3 | McMaster-Carr #5011T11 — clamps water hoses to barbs
304 SS Threaded-Rod Loop Hanger | 3273T51 (McMaster) | 31×62×22mm | 4 | McMaster-Carr #3273T51 — holds brush motor in place
Brush / Microfiber roller material | brash | 650mm long × 70mm diameter | 2 | Buy microfiber roller sleeves (paint roller replacement sleeves) — 250mm × 3 sections per roller
Silicone water hose | — | 8mm OD, 6mm ID | 2m total | Any hardware store or AliExpress
350mL PETG water tank | — | ~120×80×40mm | 1 | 3D print in PETG with 100% infill walls OR buy a small plastic bottle and adapt

2

BUILDING THE CHASSIS FRAME — STEP BY STEP

Build the skeleton first. Everything else bolts to this.

STEP 2.1

Prepare the Side Plates

Take both laser-cut mild steel side plates (820×150×3mm). Before drilling, do this:

- File all edges with a flat file — remove burrs from laser cutting
- Mark center line along the length at 75mm height from bottom edge (half of 150mm)
- This center line is where all shaft holes go
- Mark hole positions: bearing holes at X=30mm and X=790mm from front
- Mark sprocket shaft holes: spaced every ~45mm along the center line between the two bearing holes
- Mark 3 cross-brace bolt holes: at X=60mm, X=410mm, X=760mm — at both 20mm from top AND 20mm from bottom (total 6 holes per plate)

STEP 2.2

Drill All Holes in Side Plates DRILL

- Use a center punch first to mark every hole — stops the drill from wandering
- Bearing holes: Start with Ø5mm pilot drill, then open up to final bearing OD size. Use step drill bit or hole saw.
- Sprocket shaft holes: Drill Ø10.5mm (slightly larger than 10mm shaft for easy fit)
- Cross-brace holes: Drill Ø4.5mm for M4 bolts
- Motor mount holes: Drill 4× Ø4.5mm in pattern matching GF555 motor face
- After drilling, use a deburring tool or countersink bit to clean each hole opening
- Do BOTH plates together — clamp them face-to-face and drill through both at once so holes are identical

✓ Drill through both side plates clamped together — guarantees perfect alignment. Use a scrap wood board underneath to get clean exit holes.

STEP 2.3

Assemble the Frame Box

- Lay the left side plate flat on workbench
- Stand the front end plate (650×150mm) perpendicular at the front end — clamp with C-clamps
- Stand the rear end plate at the rear end — clamp
- Insert the 3× cross braces between the side plates at their marked positions
- Check all is square with a try square — adjust before bolting
- Bolt cross braces to left plate: M4×12mm bolts + flat washer + nyloc nut — do not fully tighten yet
- Now attach right side plate — bolt through to cross braces
- Check squareness again — measure diagonals (should be equal)
- Once square, fully tighten all M4 bolts. Torque to hand-tight + ¼ turn
- Bolt front and rear end plates using M4×20mm + nyloc nuts

STEP 2.4

Install Bearings in Side Plates

- Clean bearing holes with a rag — no dust or chips inside
- Apply thin layer of bearing retainer (Loctite 641) around the bearing OD
- Press bearing into hole using a mallet and a block of wood — tap evenly around the race, never hit the inner ring
- Check bearing sits flush with plate surface — should not stick out
- Let Loctite cure for 10 minutes before loading
- Repeat for all bearing positions (2 main + 6 idler shaft bearing holes)

⚠ Never hammer directly on a bearing. Always use a block of wood or a socket the same OD as the bearing outer race. Hitting the bearing directly damages the balls inside.

STEP 2.5

Mount Electronics Tray Inside Chassis

- Take the laser-cut electronics tray (600×200×2mm mild steel — paint top surface before fitting PCBs)
- Drill 4× M3 mounting holes in the tray corners
- Insert M3×10mm bolts from outside the side plate through to the tray
- Use M3 nyloc nuts inside — position tray 50mm up from bottom of chassis
- Tray should sit level and horizontal inside the chassis

3

DRIVE SYSTEM — 2× GF555 MOTORS + SPROCKETS + ST-320 TRACK (DIFFERENTIAL DRIVE)

This is what makes the robot move on the solar panel

ℹ Differential drive: This robot has TWO GF555 motors — one driving the left track, one driving the right track independently. Each motor has its own BTS7960 H-bridge. When both run forward at the same speed the robot goes straight. When one runs faster it turns toward the slower side. When they run opposite directions the robot spins in place.

STEP 3.1

Mount GF555 LEFT Motor (drives left track)

- Bolt the left motor mount plate (140×140mm mild steel) to the inside of the LEFT side of the chassis using M4×12mm bolts — or weld it directly to the side plate for maximum strength
- Position: centered at ~357mm from the front of the chassis (midpoint of the 715mm side plate)
- Align GF555 motor face to the mount plate — 4 holes pattern
- Bolt GF555 using M4×20mm bolts + flat washer + spring washer — apply Loctite 243 on threads
- GF555 output shaft must point toward the left side plate bearing — shaft runs left-to-right through the bearing and out
- Check alignment: shaft must be centered in the bearing. No side load. Tighten bolts while shaft is spinning freely.

STEP 3.1b

Mount GF555 RIGHT Motor (drives right track)

- Identical procedure to Step 3.1 — mirror image on the RIGHT side of the chassis
- Both motors are at the same lengthwise position (midpoint ≈410mm) — they are side-by-side on opposite sides
- The two motor shafts are on opposite sides — LEFT motor shaft exits left plate, RIGHT motor shaft exits right plate
- Label motors with tape: "L" and "R" to avoid wiring confusion later

STEP 3.2

Attach the Shaft Couplings (2× copling)

- Slide one 3D-printed coupling (copling, 41×30×30mm) onto each GF555 output shaft
- Each coupling connects: GF555 shaft → drive sprocket shaft for that side
- Tighten M3 set screws in each coupling using a hex key — apply Loctite 243 on set screw threads
- Pull each coupling by hand — must not slip on the shaft at all
- You should have 2 couplings total — one per GF555 motor

STEP 3.3

Install the 17 Sprocket Shafts (shaft_sheni)

- Take each 75mm long Ø10mm steel rod (you cut 17 of these earlier)
- Slide through the Ø10.5mm holes in the left side plate
- Slip a bearing onto the shaft from the inside
- Slide through the same hole position on the right side plate
- Put an E-clip (circlip) in the groove at each shaft end — this stops the shaft sliding out
- Check shaft spins freely in the bearing — no stiffness
- Repeat for all 27 shafts per side (54 total)

ℹ The 54 sprocket shafts (27 per side) span the full 715mm length of each side plate — they are what the track rides on. Space them evenly ~25mm apart along the length.

STEP 3.4

Press Sprockets onto Shafts (sheni)

- Slide one sprocket onto each of the 27 shafts per side (54 total)
- Position sprocket in the CENTER of the shaft (equal gap on both sides)
- Tighten the M3 set screw in the sprocket hub against the shaft — use Loctite 243
- Spin each sprocket by hand — should spin freely with the shaft, no wobble
- The 6 double-strand idler sprockets (6260K9, 72×72×43mm) — 3 per side — go at the tensioner positions front, center, and rear of each track. These are larger than the regular sprockets and keep track tension correct.

STEP 3.5

Install the ST-320 Rubber Track

- This is the rubber chain/track that wraps around all sprockets like a tank
- Start at the DRIVE sprocket (connected to GF555 motor)
- Loop the track around the front sprocket, then along the top row of sprockets, around the rear, and back along the bottom
- Thread track carefully over all 27 sprockets per side — do not force it
- Connect track ends: most ST-320 tracks have a master link — push the pin through and clip the E-clip
- Check track tension: press the middle of the bottom span — should deflect about 5–8mm. Not too tight, not too loose.

✓ Use the loleh (tensioner pulley, 445×20×75mm) to adjust tension — loosen the tensioner bolt, push the tensioner outward until correct tension, then re-tighten. The loleh_dakheli (inner guide, 715×149×20mm) keeps the track centered.

⚠ Track too tight = motor stalls and overheats. Track too loose = track jumps off sprockets. 5–8mm deflection at center is correct.

STEP 3.6

Test Both Drive Motors Before Continuing

- Connect LEFT GF555 motor temporarily to a 24V power supply — left track should move forward
- Disconnect. Connect RIGHT GF555 motor to 24V — right track should move forward
- Test both together at 24V — robot should drive straight without pulling to one side
- Listen for: grinding (bad alignment), clicking (track too loose), squealing (bearing dry)
- Test differential spin: apply 24V to LEFT forward + RIGHT reversed — robot should spin in place clockwise
- All good → disconnect power and continue to Phase 4
- If one track is faster: slightly reduce that motor's run time during the test to compare torque

4

BRUSH + WASH ASSEMBLY (× 2 identical) BUY 3D PRINT

Build this assembly twice — one for front, one for rear of the robot

ℹ This is the wash-assemble1 from your model. You have 2 identical assemblies. Build one, test it, then build the second identical to the first.

STEP 4.1

Build the Brush Roller (brash — 650×70×70mm)

- Take the Ø20mm × 670mm mild steel round bar (brush roller shaft) — sand smooth, paint with primer before fitting
- Slide bearing (5972K244, 30×30×7mm) onto each end of the shaft
- Push each bearing into the brush assembly side bracket hole
- Wrap microfiber roller sleeve over the mild steel shaft — the sleeve is the actual brush material that contacts the panel
- Secure sleeve with stainless zip ties at both ends and middle (3 zip ties per roller)
- Check roller spins freely in the side brackets

STEP 4.2

Mount 6331K61 DC Motor for Brush Drive

- Print DC-motor-bracket (61×36×35mm) in PETG
- Bolt the 6331K61 motor (30×37×83mm) into the printed bracket using M3×10mm screws
- Mount the bracket onto the brush assembly side plate using 3273T51 loop hangers — M3×16mm bolts through loop hanger holes
- Motor shaft must be parallel to the brush roller shaft — check with a ruler
- Motor shaft end should be at the same height as the brush shaft end (both shafts coplanar)

STEP 4.3

Install Timing Belt Pulleys + Belt

- Slide the small timing belt pulley (1277N723, 54mm dia) onto the motor shaft
- Tighten set screw with M3 hex key — Loctite 243 on thread
- Slide the large timing belt pulley (1277N725, 57mm dia) onto the brush roller shaft end
- Tighten set screw
- Loop the timing belt (Belt1-3, 107mm span) over both pulleys
- Adjust motor bracket position by loosening loop hangers — move motor away from roller until belt is taut (should not slip when you press it)
- Lock motor bracket position — tighten all loop hanger bolts
- Use the 4147N173 flexible shaft coupling if the motor shaft and brush shaft are slightly misaligned (connects motor shaft extension to brush shaft)

STEP 4.4

Install Water Jet Pipe (water-jet — 500mm)

- Take the 500mm mild steel tube (or 304 stainless tube if available) with 1.5mm spray holes drilled every 50mm along the bottom — stainless is better here since water flows inside
- Attach barbed tube fittings (9675T18) at both ends of the tube using worm-drive hose clamps (5011T11)
- Mount the water jet tube on the brush assembly frame — above and slightly in front of the brush roller
- Use M3×10mm bolts through small drilled holes in the tube wall to fix it to the side brackets
- Connect silicone hose from T-part-assemble to the barbed fitting

STEP 4.5

Assemble T-Part Water Splitters (×4 total — 2 per brush assembly)

- Each brush assembly (wash-assemble1) has 2× T-part-assemble — so you need 4 T-parts total for the whole robot
- Each T-part-assemble = T-cleaner-body + head-of-T-cleaner joined together (580×42×23mm full length)
- The two T-parts in each brush assembly split water to the left and right halves of the brush roller
- Print each in 3 sections (each ~193mm long) in PETG at 100% wall thickness for water tightness
- Join sections with M3×16mm bolts and silicone sealant on the joint faces — let sealant cure 24h before water testing
- Mount both T-parts along the brush assembly top rail using M3 bolts through the T-part base
- Water path: pump → main hose → FRONT brush T-parts (×2) → front water-jets; pump → branch hose → REAR brush T-parts (×2) → rear water-jets

ℹ Total water system: 1 pump → solenoid valve → splits to front + rear hoses → each goes to 2× T-parts on that brush assembly → 4 water-jet spray lines total across the robot width.

STEP 4.6

Mount Brush Assembly to Chassis

- Front brush assembly: slide into front slot of chassis, between the track on left and right
- Use connector and connector2 (3D printed) to lock the assembly to the chassis sides
- Bolt connectors with M4×30mm bolts through chassis side plate → connector → brush frame
- Use hinge pin (21×4×19mm printed housing + M4 bolt as pin) to allow slight float — brush can tilt ±2° to follow panel surface
- Attach splash guard (gard, 615×120mm mild steel 2mm, bent to shape) over the brush roller — curves downward on each side. Paint both faces before fitting.
- Bolt splash guard with M3×10mm through the side brackets
- Repeat for rear brush assembly

✓ The slight float via hinge pins is important — solar panels are not perfectly flat. The brush needs to self-adjust to maintain contact across the full 650mm width.

5

SENSOR MOUNTING — EXACT POSITIONS

All 10 sensors — where exactly to put them and how to fix them

Sensor | Qty | Position on Robot | Mounting Method | Height from Panel Surface
TCRT5000 IR edge sensor | 4 | One at each of the 4 corners — pointing straight down | 3D-printed L-bracket, 2× M3 screws. Sensor face looks at panel surface. | 8–12mm above panel surface when robot is on the panel
HC-SR04 Ultrasonic | 2 | Front face of robot — left half and right half of front plate | 3D-printed ultrasonic mount, M3 screws through front plate | Parallel to panel surface, pointing forward horizontally
MPU-6050 IMU | 1 | Center of electronics tray — inside chassis | M2 nylon standoffs × 4 — must be perfectly flat/level | Inside chassis — not relevant
DS3231 RTC | 1 | Electronics tray — any open area | M2 nylon standoffs | Inside chassis
ESP8266 NodeMCU | 1 | Electronics tray — near chassis edge (antenna side facing outside) | M3 nylon standoffs × 4 | Inside chassis — keep antenna end near a gap for WiFi signal
Dock IR receiver | 1 | Rear face of robot — center of rear plate | Drill 5mm hole in rear plate. Hot glue receiver into hole. Route wire inside. | Same height as dock IR LED on the charging station
Capacitive water level | 1 | Side wall of water tank | Stick-on adhesive backing of sensor. Route wire to electronics tray. | On tank wall — facing into tank

IMPORTANT

IR Sensor Corner Bracket — How to Make It

- Print the IR sensor L-bracket in PETG (40×40×20mm)
- One face of the L attaches to the corner of the chassis (M3 bolt into chassis)
- The other face of the L is horizontal — sensor mounts on it pointing DOWN
- The sensor face should be 8–12mm above the panel when the robot sits on the panel
- Angle the sensor slightly outward (10°) — this detects the edge 1–2cm before the track reaches it, giving the robot time to stop
- After mounting, adjust the small potentiometer on the sensor with a screwdriver until LED on sensor goes ON over the panel and OFF over air/edge

6

FINAL ASSEMBLY — CORRECT ORDER TO PUT IT ALL TOGETHER

Follow this order exactly — doing it wrong means disassembling later

Order | What to do | Check before moving on
1 | Build chassis frame box (Phase 2) | Frame is square. All bolts tight. Bearings pressed in flush.
2 | Install all sprocket shafts + sprockets (Phase 3.3–3.4) | All shafts spin freely. No wobble. Sprockets locked with set screws.
3 | Mount LEFT + RIGHT GF555 motors + couplings (Phase 3.1–3.2) | Both motors bolted solid. Both couplings tight on shafts. Both motor shafts run true in bearings.
4 | Install ST-320 track (Phase 3.5) | Track on all sprockets. Correct tension (5–8mm deflection). Track centered.
5 | Test both drive motors independently, then together (Phase 3.6) | Both tracks move smoothly. No noise. Differential spin test passes. No derailment.
6 | Build both brush assemblies (Phase 4.1–4.5) | Both rollers spin freely. Belts not slipping. Water jet holes open.
7 | Mount electronics tray + Arduino + drivers inside chassis | Tray level. All PCBs on standoffs. No PCB touching chassis metal.
8 | Route all wiring (follow wiring diagram) | All wires tied. Power wires away from signal wires. No bare wires touching chassis.
9 | Mount brush assemblies to chassis front and rear (Phase 4.6) | Both assemblies locked. Hinge pins inserted. Splash guards attached.
10 | Mount water tank + pump + T-part + hoses | All hose connections tight (hose clamps). No leaks. Tank full hold without drip.
11 | Mount all sensors (Phase 5) | IR sensors pointing down. Ultrasonic pointing forward. IMU flat and level.
12 | Install top cover plate | All cables accessible through cutouts. Cover sits flush.
13 | Mount IR sensor corner brackets on outside corners | Sensor 8–12mm above ground when robot sits flat. Potentiometer adjusted.
14 | Final mechanical check (Phase 7) | See checklist below.

7

MECHANICAL CHECKLIST BEFORE FIRST RUN

Go through every item — do not power on until all boxes are checked

### Frame & Drive

- All M4 frame bolts tightened (no hand-loose bolts)
- Nyloc nuts used on all vibrating joints (track area)
- Loctite applied to all set screws (motor coupling, sprockets)
- All bearings pressed fully flush — none sticking out
- All 54 sprocket shafts (27 per side) have E-clips on both ends
- ST-320 track master link clip is fully seated
- Track tension: 5–8mm deflection at center span
- Track centered on sprockets — not riding to one side
- BOTH motor couplings tight — pull by hand, should not slip
- LEFT motor coupling and RIGHT motor coupling both checked separately
- Rotate each drive shaft by hand — that track moves smoothly, no stiff spots

### Brush & Water

- Both brush rollers spin freely by hand
- Timing belts are taut — does not skip teeth when pressed
- Belt pulleys set-screwed and Loctited on shafts
- Splash guards bolted on — no loose edges
- All hose connections have clamps fully tightened
- Fill tank with water — leave 5 min — no drips anywhere
- Water jet spray holes all open (poke with pin if blocked)
- T-part joints sealed with silicone — no leaks
- Brush microfiber sleeves secured with zip ties
- Hinge pins inserted — brush can float ±2° but not fall off

### Sensors

- All 4 IR sensors pointing straight down at corners
- IR sensor height: 8–12mm above a flat surface when robot sits on it
- Pot on each IR sensor adjusted — LED ON over surface, OFF over air
- Both ultrasonic sensors pointing forward, horizontally
- IMU mounted flat — verify with spirit level
- All sensor wires tied — cannot catch on moving parts
- Dock IR receiver positioned at rear center

### General Safety

- No loose wires near track or brush rollers
- All cable ties trimmed — no sharp protruding ends
- Electronics tray bolted — does not rattle when chassis shaken
- Battery strapped with velcro — does not slide
- Top cover sits flush — no pinched wires
- Robot placed on flat surface — sits stable without rocking

✓ You are ready for electrical work once all items above are checked. Refer to SolarCleanerBot_WiringDiagram.html for all electrical connections and AutonomousGuide.html for firmware.

⬇

Component Files — Cut, Print & Reference

All STEP files exported directly from Assem1.SLDASM · Open in any CAD slicer or send to laser cutter / 3D printer

ℹ STEP format works in Fusion 360, SolidWorks, FreeCAD, PrusaSlicer, Bambu Studio, and any CNC/laser CAM software. For 3D printing, import the STEP into your slicer and export as G-code. For cutting, import into your CAM tool and set material to 3mm mild steel.

CATEGORY 1

🖨 3D Print Parts — PETG filament recommended (outdoor heat resistant)

Part Name | Description | Qty | Download
main_body | Main chassis body — split into 2 separate print files: • Part 1: 550×117×500mm • Part 2: 650×206×390mm | 1+1 | main_body_part1.stl main_body_part2.stl
gholab | Cover / shell panel | 1 | gholab.step
rabet | Rebate / locating bracket | 1 | rabet.step
copling | Shaft coupling block (5 bodies) — connects GF555 shaft to drive sprocket | 2 | copling.step
sheni | Track link / sheni sprocket segment | 54 | sheni.step
shaft_sheni | Sprocket shaft — Ø10mm × 49mm, cut from mild steel rod | 54 | shaft_sheni.step
loleh | Pulley / roller outer | 2 | loleh.step
loleh_dakheli | Pulley / roller inner | 2 | loleh_dakheli.step
dasteh | Handle / arm bracket | 2 | dasteh.step
3rahi | Three-way junction / T-body support | 2 | 3rahi.step
shaft_harzgard | Idler shaft — goes through idler sprocket | 6 | shaft_harzgard.step
gard | Splash guard / side guard panel | 2 | gard.step
head-of-T-cleaner | T-cleaner nozzle head — water outlet end | 4 | head-of-T-cleaner.step
T-cleaner-body | T-cleaner main body — water distribution tube | 4 | T-cleaner-body.step
pin | Locking pin / retaining pin | 8 | pin.step
connector | Pipe connector — hose barb adapter | 2 | connector.step
connector2 | Pipe connector variant 2 | 2 | connector2.step
motor-DC-shaft | Brush motor drive shaft extension | 2 | motor-DC-shaft.step
Belt1-3 | Timing belt (print flexible or buy GT2 belt) | 2 | Belt1-3.step
DC-motor-bracket | Brush motor mounting bracket | 2 | DC-motor-bracket.step
water-jet | Water jet nozzle bar — runs along brush roller | 2 | water-jet.step
brash | Brush roller — main cleaning brush that sweeps the solar panel surface | 2 | brash.step

✓ Print all parts in PETG — minimum 3 walls, 30% infill. PLA will warp in outdoor heat on solar panels.

CATEGORY 2

🔩 Cut Mild Steel Parts — send to laser cutter or waterjet

Part Name | Description | Qty | Download
structure | Full chassis structure — 12 steel bars split into individual files, dimensions in filename (all 40×20mm cross-section mild steel): 4× cross bars 1000mm long · 4× side rails 1866mm long · 4× additional frame members | 12 pcs | body1 — 40×1000×20mm body2 — 40×1000×20mm body3 — 40×1000×20mm body4 — 40×1000×20mm body5 — 40×1866×20mm body6 — 40×1866×20mm body7 — 40×1866×20mm body8 — 40×1866×20mm body9 — 40×1000×20mm body10 — 40×1000×20mm body11 — 40×1866×20mm body12 — 40×1866×20mm

⚠ After cutting, deburr all edges with a file. Drill all holes at correct diameter before assembly. Apply zinc primer + enamel topcoat on all faces — mild steel will rust outdoors without paint.

CATEGORY 3

🔧 Sub-Assembly Reference Files — for checking fit before build

Assembly Name | Description | Download
1ofsheni | Single track link assembly — shaft + sheni + bearing stack | 1ofsheni.step
T-part-assemble | Full T-cleaner assembly — water jet + T-body + head + pins (4× total in robot) | T-part-assemble.step
wash-assemble1 | Full brush wash assembly — brush roller + gard + water-jet + motor + belt + T-parts (2× in robot) | wash-assemble1.step
ST-320 | Track assembly — full rubber track (ST-320 model) | ST-320.step
robot5 | Full robot sub-assembly reference | robot5.step

CATEGORY 4

🛒 Bought / Off-the-Shelf Parts — reference STEP files for fit checking

Part Name | Description | Download
GF555 | GF555 geared DC motor — 2× required (one per track side) | GF555.step
6260K9 Idler Sprocket | Double-strand roller chain idler sprocket — 6× required | 6260K9_idler_sprocket.step
6331K61 Brush Motor | Compact round-face DC motor for brush rollers — 2× required | 6331K61_brush_motor.step
5972K244 Ball Bearing | Brush guard ball bearing — 2× per brush assembly | 5972K244_bearing.step
instrument ball bearing | Instrument ball bearing for idler shafts | instrument_ball_bearing.step
radial ball bearing 68 | Radial ball bearing for main shaft | radial_ball_bearing_68.step
4147N173 Shaft Coupling | Set screw precision flexible shaft coupling | 4147N173_shaft_coupling.step
1277N723 Belt Pulley | Corrosion-resistant timing belt pulley (driver) | 1277N723_pulley.step
1277N725 Belt Pulley | Corrosion-resistant timing belt pulley (driven) | 1277N725_pulley.step
9675T18 Barbed Fitting | Odor-resistant plastic barbed tube fitting — water inlet | 9675T18_barbed_fitting.step
5011T11 Hose Clamp | Worm-drive clamp for hose and tube | 5011T11_hose_clamp.step
3273T51 Loop Hanger | 304 stainless steel threaded-rod-mount loop hanger | 3273T51_loop_hanger.step
90967A220 Retaining Ring | External retaining ring (E-clip) for sprocket shafts | 90967A220_retaining_ring.step
Hardware (screws/nuts/washers) | M3 pan head screws, spring washers, socket head cap screws, set screws, hex flange nuts, countersunk screws | socket_cap_screw.step · countersunk_screw.step · set_screw.step · tapping_screw.step · hex_nut.step · spring_washer.step

ℹ These are reference STEP files — you buy these parts, not print or cut them. Use the STEP files to verify fit in your CAD tool before ordering.

SolarCleanerBot · Mechanical Build Guide v3 · Panel: 2000×1000mm · 2× GF555 Differential Drive · Mild Steel + 3D Print (no aluminium) · Generated by Claude Code · 2026-05-15
