Harshul1484/full_panel_cleaner_Robot/SolarCleanerBot_WiringDiagram.html

# SOLARCLEANERBOT — WIRING DIAGRAM

Verified from Assem1.SLDASM · 2× GF555 Drive Motors · Differential Steering · 2× Brush Assembly · 24V System

✓ MODEL-ACCURATE — studied from Assem1.SLDASM: 55 unique parts · 359 bodies · 2× GF555 · 54× track links · 2× wash-assemble1

24V Power

12V Rail

5V Logic

GND

PWM Signal

Digital Signal

Water / Fluid

Mechanical

① SYSTEM BLOCK DIAGRAM — AS PER ASSEM1.SLDASM

② POWER ARCHITECTURE

Power Flow 24V → Rails

24V BATTERY PACK3S2P 18650 or 4S LiPo · 5–6 Ah

BMS 10A — over-discharge · balance · short protection

24V MOTOR RAILDirect from BMS · 20A blade fuse · feeds 2× BTS7960

12V AUX RAILLM2596 buck 5A · brush motors + pump + solenoid

5V LOGIC RAILLM2596 buck 3A · Arduino + sensors + ESP8266

Each BTS7960 has its own 10A inline fuse on the 24V feed.
Total peak draw: 2× GF555 (~3A each) + 2× brush (~1.5A each) + pump (~1A) = ~11A @ 24V.

Wire Gauge Guide

Battery → BMS → Fuse14 AWG · XT60 connectors

Fuse → BTS7960 #1 B+14 AWG

Fuse → BTS7960 #2 B+14 AWG

BTS7960 → GF555 motor16 AWG · short run

12V rail → L298N + pump18 AWG

5V rail → Arduino + sensors22 AWG · JST

MCU signal wires26 AWG

Encoder / I2C wires28 AWG shielded

③ DRIVE SYSTEM — 2× GF555 MOTORS + 2× BTS7960 H-BRIDGE (DIFFERENTIAL STEERING)

BTS7960 #1 LEFT track driver

B+ (24V)24V Rail · 10A fuse

B− (GND)Common GND

VCC (5V)5V Rail

RPWMArduino D9 (PWM FWD)

LPWMArduino D10 (PWM REV)

R_ENArduino D2 (HIGH=enable)

L_ENArduino D3 (HIGH=enable)

M+ / M−→ GF555 #1 (LEFT)

BTS7960 #2 RIGHT track driver

B+ (24V)24V Rail · 10A fuse

B− (GND)Common GND

VCC (5V)5V Rail

RPWMArduino D11 (PWM FWD)

LPWMArduino D12 (PWM REV)

R_ENArduino D4 (HIGH=enable)

L_ENArduino D5 (HIGH=enable)

M+ / M−→ GF555 #2 (RIGHT)

GF555 #1 LEFT copling #1 → LEFT chain

Variklio korpusas (motor body) · 70×123×134mm · 24V geared

Motor +BTS7960 #1 M+

Motor −BTS7960 #1 M−

Output shaftcopling → 27× 1ofsheni LEFT chain

Encoder VCC5V Rail

Encoder AArduino D18 (INT3)

Encoder BArduino D19 (INT2)

3× 6260K9 idler sprockets on LEFT side
6× shaft_harzgard · 6× instrument bearings shared

GF555 #2 RIGHT copling #2 → RIGHT chain

Variklio korpusas · identical to #1 · 243mm apart in X

Motor +BTS7960 #2 M+

Motor −BTS7960 #2 M−

Output shaftcopling → 27× 1ofsheni RIGHT chain

Encoder VCC5V Rail

Encoder AArduino D20 (INT1 — note: shared I2C SDA)

Encoder BArduino D21 (INT0 — note: shared I2C SCL)

⚠ D20/D21 are also I2C SDA/SCL — use D36/D37 for encoder #2 to avoid conflict

✓ DIFFERENTIAL STEERING: Forward = both motors same speed. Turn LEFT = slow/stop GF555 #1, run GF555 #2. Turn RIGHT = slow/stop GF555 #2, run GF555 #1. Spin in place = one motor forward, other reverse.

④ BRUSH SYSTEM — 2× 6331K61 BRUSH MOTORS + L298N (wash-assemble1 × 2)

L298N Dual H-bridge Both brush motors

VS (motor power)12V Rail

VSS (logic)5V Rail

GNDCommon GND

ENA (PWM)Arduino D6 — FRONT brush speed

ENB (PWM)Arduino D7 — REAR brush speed

IN1Arduino D22 — FRONT dir A

IN2Arduino D23 — FRONT dir B

IN3Arduino D24 — REAR dir A

IN4Arduino D25 — REAR dir B

OUT1/2→ 6331K61 FRONT brush motor

OUT3/4→ 6331K61 REAR brush motor

6331K61 Motor × 2 McMaster-Carr DC motor

30×37×83mm · 12V · one per wash-assemble1

FRONT motor +/−L298N OUT1/OUT2

REAR motor +/−L298N OUT3/OUT4

Shaft → coupling4147N173 flex coupling → brush shaft

Belt drive1277N723 pulley → Belt1-3 → 1277N725

Belt1-3107mm span · 11mm wide · 2 belts total

BracketDC-motor-bracket · 3273T51 loop hangers ×4

Add 1N4007 flyback diode across each motor terminal. L298N module usually has these built in.

Brush Assembly Details wash-assemble1 × 2

Each assembly contains (from model):

brash roller650×69×70mm microfiber roller

gard (splash guard)615×120×167mm aluminium

water-jet pipe500×22×111mm · spray holes

T-part-assemble × 2580×42×23mm water splitter

head-of-T-cleaner × 214×23×580mm nozzle head

T-cleaner-body × 223×33×580mm body

5972K244 bearing × 230×30×7mm brush shaft bearings

connector + connector247×40×30mm chassis lock

pin × 221×4×19mm hinge pins

⑤ WATER SYSTEM — PUMP + SOLENOID + 4× T-PART ASSEMBLIES

Pump 12V (Peristaltic)

GateIRLZ44N ← Arduino D8

Motor +12VIRLZ44N Drain → 12V

SourceGND

Flyback1N4007 across pump

NC Solenoid Valve 12V

GateIRLZ44N ← Arduino D13

Coil +12VIRLZ44N Drain → 12V

SourceGND

Flyback1N4007 across coil

Normally-closed: water off when power lost

Water Flow Path (from model)

Tank (350mL) → Pump →
Solenoid valve →
9675T18 barb fitting ×3 →
5011T11 hose clamps ×3 →
T-part-assemble FRONT ×2 →
head-of-T-cleaner → water-jet pipe 500mm →
T-part-assemble REAR ×2 →
head-of-T-cleaner → water-jet pipe 500mm

⑥ SENSORS (AUTONOMOUS)

IR Edge × 4 TCRT5000

FL DOArduino D26

FR DOArduino D27

RL DOArduino D28

RR DOArduino D29

All VCC5V Rail

LOW = on panel · HIGH = edge/air → TURN

HC-SR04 × 2 Front obstacle

L TRIGArduino D30

L ECHOArduino D31 (via divider)

R TRIGArduino D32

R ECHOArduino D33 (via divider)

VCC5V Rail

<8cm → OBSTACLE state

IMU + RTC I2C bus

MPU-6050 SDAArduino D20 (I2C)

MPU-6050 SCLArduino D21 (I2C)

MPU-6050 AD03.3V → addr 0x69

DS3231 SDAArduino D20 (shared)

DS3231 SCLArduino D21 (shared)

DS3231 INTArduino D2 (alarm)

Other Sensors

Water level cap.Arduino A0

Vbat dividerArduino A1

Dock IR receiverArduino D34

ESP8266 RXArduino TX2 D16

ESP8266 TXArduino RX2 D17

⑦ COMPLETE WIRING NETLIST

FROM | FROM PIN | TO | TO PIN | SIGNAL NAME | NOTES
24V Battery | B+/B− | BMS 10A | IN+/IN− | VBAT_RAW | XT60 · 14AWG
BMS | OUT+ | 20A Fuse | IN | VBAT_FUSED | 14AWG inline
20A Fuse | OUT | BTS7960 #1 B+ | B+ | 24V_MOTOR_L | 14AWG + 10A inline fuse
20A Fuse | OUT | BTS7960 #2 B+ | B+ | 24V_MOTOR_R | 14AWG + 10A inline fuse
BMS | OUT+ | LM2596 #1 (12V) | VIN | 12V_IN | 18AWG
BMS | OUT+ | LM2596 #2 (5V) | VIN | 5V_IN | 18AWG
LM2596 #2 | 5V OUT | Arduino Mega | VIN | 5V_LOGIC | 22AWG
Arduino | D9 PWM | BTS7960 #1 | RPWM | LEFT_FWD_PWM | 26AWG
Arduino | D10 PWM | BTS7960 #1 | LPWM | LEFT_REV_PWM | 26AWG
Arduino | D2 | BTS7960 #1 | R_EN | LEFT_FWD_EN | 26AWG
Arduino | D3 | BTS7960 #1 | L_EN | LEFT_REV_EN | 26AWG
BTS7960 #1 | M+/M− | GF555 #1 LEFT | +/− | MOTOR_LEFT | 16AWG + 1N4007
Arduino | D11 PWM | BTS7960 #2 | RPWM | RIGHT_FWD_PWM | 26AWG
Arduino | D12 PWM | BTS7960 #2 | LPWM | RIGHT_REV_PWM | 26AWG
Arduino | D4 | BTS7960 #2 | R_EN | RIGHT_FWD_EN | 26AWG
Arduino | D5 | BTS7960 #2 | L_EN | RIGHT_REV_EN | 26AWG
BTS7960 #2 | M+/M− | GF555 #2 RIGHT | +/− | MOTOR_RIGHT | 16AWG + 1N4007
GF555 #1 encoder | A/B | Arduino | D18/D19 | ENC_L_A/B | 28AWG shielded
GF555 #2 encoder | A/B | Arduino | D36/D37 | ENC_R_A/B | 28AWG shielded
Arduino | D6 PWM | L298N | ENA | BRUSH_FRONT_SPD | 26AWG
Arduino | D7 PWM | L298N | ENB | BRUSH_REAR_SPD | 26AWG
Arduino | D22/D23 | L298N | IN1/IN2 | BRUSH_FRONT_DIR | 26AWG
Arduino | D24/D25 | L298N | IN3/IN4 | BRUSH_REAR_DIR | 26AWG
L298N | OUT1/2 | 6331K61 FRONT | +/− | MOTOR_BRUSH_F | 16AWG
L298N | OUT3/4 | 6331K61 REAR | +/− | MOTOR_BRUSH_R | 16AWG
Arduino | D8 | IRLZ44N (Pump) | Gate | PUMP_CTRL | + 1N4007
Arduino | D13 | IRLZ44N (Sol.) | Gate | SOL_CTRL | NC valve
IR FL | DO | Arduino | D26 | EDGE_FL | corner FL
IR FR | DO | Arduino | D27 | EDGE_FR | corner FR
IR RL | DO | Arduino | D28 | EDGE_RL | corner RL
IR RR | DO | Arduino | D29 | EDGE_RR | corner RR
HC-SR04 L | TRIG/ECHO | Arduino | D30/D31 | US_L | echo via divider
HC-SR04 R | TRIG/ECHO | Arduino | D32/D33 | US_R | echo via divider
MPU-6050 | SDA/SCL | Arduino | D20/D21 | I2C_IMU | 4.7kΩ pull-ups
DS3231 RTC | SDA/SCL | Arduino | D20/D21 | I2C_RTC | shared bus
DS3231 | SQW/INT | Arduino | D2 (INT5) | RTC_ALARM | daily start trigger
Cap. water sensor | OUT | Arduino | A0 | WATER_LVL | analog
Vbat divider | mid | Arduino | A1 | VBAT_SENSE | 100k+10k
Dock IR receiver | OUT | Arduino | D34 | DOCK_SENSE | active LOW
ESP8266 | TX/RX | Arduino | D17/D16 (Serial2) | WIFI_UART | 115200 baud

⑧ EXACT COMPONENT COUNT FROM ASSEM1.SLDASM

Part (Model Name) | Qty in Model | Dims (mm) | Category | Notes
GF555.STEP (Variklio korpusas) | 2 | 70×123×134 | Drive motor | One per track side — differential steering
copling | 2 | 41×30×30 | Shaft coupling | Connects GF555 shaft to track chain
1ofsheni (track links) | 54 | 49×17×51 | Track | 27 per side (LEFT and RIGHT chains)
sheni (sprocket) | 54 | 50×45×10 | Track sprocket | One per 1ofsheni link shaft
shaft_sheni | 54 | 49×3×3 | Link shaft | One per track link
6260K9 Idler Sprocket | 6 | 72×72×43 | Idler sprocket | 3 per side — guide and tension track
shaft_harzgard | 6 | 10×10×75 | Idler shaft | One per idler sprocket
instrument ball bearing_ai | 6 | 4×16×16 | Bearing | One per idler shaft
radial ball bearing_68_am | 1 | 5×44×44 | Main bearing | Main drive shaft — large side
radial ball bearing_68_am (1) | 1 | 5×37×37 | Main bearing | Main drive shaft — smaller side
ST-320 | 1 | 49×25×42 | Track module | Complete rubber track assembly
Axe.step | 1 | 49×22×24 | Drive axle | Main drive axle connecting both chains
Composant2.step | 1 | 1×24×24 | Retaining part | Thin disc — shaft retainer or spacer
90967A220 Retaining Ring | 1 | 1×23×20 | Circlip | External retaining ring — shaft end
loleh | 1 | 445×20×75 | Tensioner pulley | Track tension adjustment bar
loleh_dakheli | 1 | 715×149×20 | Inner guide | Inner track guide plate
wash-assemble1 | 2 | 650×193×219 | Brush assembly | Front and rear brush/wash units
brash | 2 | 650×69×70 | Brush roller | Microfiber cleaning roller
gard | 2 | 615×120×167 | Splash guard | Water/debris deflector
water-jet | 2 | 500×22×111 | Water nozzle | Spray pipe — one per brush assembly
T-part-assemble | 4 | 580×42×23 | Water splitter | 2 per brush assembly
head-of-T-cleaner | 4 | 14×23×580 | Nozzle head | T-part nozzle head — 2 per brush assy
T-cleaner-body | 4 | 23×33×580 | T-part body | T-part tube body — 2 per brush assy
6331K61 DC Motor | 2 | 30×37×83 | Brush motor | One per brush assembly
DC-motor-bracket | 2 | 61×36×35 | Motor bracket | Holds brush motor
4147N173 Flex Coupling | 2 | 25×25×38 | Shaft coupling | Motor → brush roller shaft
1277N723 Belt Pulley (small) | 2 | 54×54×23 | Pulley | On brush motor shaft
1277N725 Belt Pulley (large) | 2 | 57×57×23 | Pulley | On brush roller shaft
Belt1-3 | 2 | 107×171×11 | Timing belt | Motor → brush roller drive
3273T51 Loop Hanger | 4 | 31×62×22 | Bracket | 2 per brush assembly — motor support
5972K244 Ball Bearing | 4 | 30×30×7 | Bearing | 2 per brush assembly — roller shaft ends
connector + connector2 | 2+2=4 | 47×40×30 | Chassis lock | Lock brush assembly to chassis
pin | 4 | 21×4×19 | Hinge pin | 2 per brush assembly — articulation
motor-DC-shaft | 2 | 10×43×10 | Shaft extension | Extends brush motor shaft to pulley
9675T18 Barbed Fitting | 3 | 67×17×17 | Plumbing | Water hose barb connectors
5011T11 Hose Clamp | 3 | 28×30×17 | Plumbing | Worm-drive clamps on hose joints
structure | 1 | ~1015×189×156cm* | Chassis | *Unit anomaly in model. Main frame.
main_body | 1 | 650×303×500 | Body shell | Top cover / body enclosure
rabet | 1 | 450×30×50 | Frame bar | Connecting frame bar
gholab | 1 | 51×7×48 | Frame piece | Internal frame sub-part
loleh_dakheli | 1 | 715×149×20 | Inner guide | Track inner guide
dasteh | 2 | 12×32×91 | Handle bracket | Side handles
3rahi | 1 | 24×37×60 | 3-way bracket | Junction bracket

SolarCleanerBot · Wiring Diagram · Model-accurate from Assem1.SLDASM · 55 unique parts · 2× GF555 · 54× track links · Generated 2026-05-15
